bloodf/spoolancer/viewer/README.md

# Spoolancer assembly explorer

A standalone, offline-capable 3D view of the **OLED + five LEDs** and **five LEDs + web controls** enclosures. The v0.8.1 models use actual CAD tessellations, with eight independently selectable printed pieces: base, one-piece cradle, load-cell spacer, NFC tower, reader cassette, rear cover, glue-on base top cover and small NFC cable cap.

## Open locally

From this folder, run:

```sh
python3 -m http.server 8874 --bind 127.0.0.1
```

Open the [local viewer](http://127.0.0.1:8874/). A local HTTP server is necessary because browsers restrict module and asset loading through `file://`. No internet connection is needed after downloading the folder. Use a WebGL2-capable browser.

The viewer is also suitable for static hosting such as GitHub Pages. Every asset URL is relative. This folder is a separate desktop/browser deliverable; **do not copy it into the ESP32's web filesystem**.

## Explore

- Drag to orbit, scroll or pinch to zoom, right-drag or two-finger drag to pan. Focus the canvas and use arrow keys to pan.
- Move **Open the assembly** between assembled and exploded positions.
- Select a numbered component or a list entry. Use **Focus**, **Isolate part** or **Hide part** to inspect it.
- **See inside housing** makes the base, cradle, reader tower, cassette, rear cover, base top cover and cable cap transparent. Hardware references, the spool, cable/clearance references and part numbers have separate toggles.
- **Cable / clearances** shows the nominal reader wire loop and its tail into the base. These are representative spaces, not simulated wires at every reader height.
- **Reset** restores the complete assembled model. **Fit view** frames the visible parts. Standard front, side and top views are available.
- Both light and dark themes work locally; the preference is saved when browser storage is available.

No converter, converter mount or reserved converter volume is modeled. Fit and insulate a 12 V-to-5 V converter against a suitable fixed wall only after checking the actual board, cable route and clearances. Hardware envelopes remain provisional. Any cable paths shown are dimensional references, not qualified cable assemblies. Electrical terminations, threads, screw drives, adhesive and the user-drilled jack are not represented. Exploded offsets illustrate component locations, not a collision-free assembly sequence. Original CAD coordinates are retained at 0% explosion. Flat face shading preserves mechanical edges; the viewer does not smooth or modify the shape.

The spool and glued reader tower sit on one floating cradle with integral ramps and fixed sides. Only reader height adjusts. The base, glued top cover, cable cap and front controls stay fixed. To service the base, remove the spool, disconnect power and the NFC lead, then remove the two moving-end load-cell screws and lift the cradle while supporting its spacer. The top cover remains fixed; electronics access requires releasing its glue joint. The viewer's exploded offsets do not illustrate this service motion. Physical fit, strength, bond retention and weighing accuracy remain untested.

## Rebuild and verify from the repository

```sh
python3 tools/build_viewer.py
python3 tools/build_viewer.py --check
node viewer/model.test.mjs
```

No FreeCAD installation is needed for these commands. Regenerate CAD scenes first when geometry changes. The builder consumes `cad/variants/{headless-led,oled-led}/previews/scene.json` and the shared `cad/assembly-parts.json` numbering, descriptions and explode offsets. It fails on unmapped meshes, duplicated assignments, missing components, malformed triangles, non-finite coordinates or any printed instance without its own selectable part. `--check` checks exact generated bytes without changing files.

The output pairs in `assets/` contain compact Float32 positions and Uint32 triangle indices, plus source and binary SHA-256 hashes. Float32 conversion introduces only normal floating-point rounding at this scale. CAD STEP and FreeCAD files remain the manufacturing source of truth. All binary arrays use little-endian storage.

## Dependencies and license

- Three.js **0.180.0 / r180**, including OrbitControls: MIT. The pinned upstream files and full notice are in `vendor/`. Source: [three.js r180](https://github.com/mrdoob/three.js/tree/r180).
- Spoolancer viewer, metadata and generated geometry: MIT, same as the project. See `LICENSE` in this folder.
- The icon is the project's existing Spoolancer brand asset.

No CDN is contacted at runtime. The Three.js files were obtained from the version-pinned package paths under `https://unpkg.com/three@0.180.0/`; `vendor/SHA256SUMS.txt` records their exact bytes. The generated viewer assets include their source hashes so static hosting can be audited against the committed CAD scenes.
