bloodf/spoolancer/archive/v0.1-flat/SUPERSEDED.md

Superseded by the upright v0.2 design. The user rejected the flat spool orientation. This folder preserves the prior files for reference only. Do not use these files for the current build.
