bloodf/spoolancer/archive/v0.2-upright/SUPERSEDED.md

Superseded by the compact v0.3 design with side-mounted NFC. This folder preserves v0.2 for reference only.
