bloodf/spoolancer/cad/previews/boot-access.png

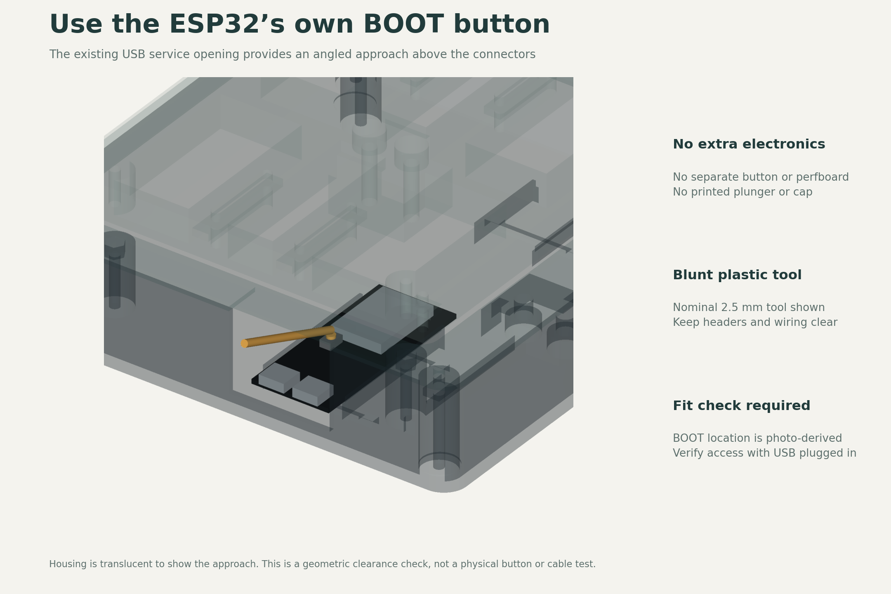
cad/previews/boot-access.png
