bloodf/spoolancer/cad/previews/cradle.png

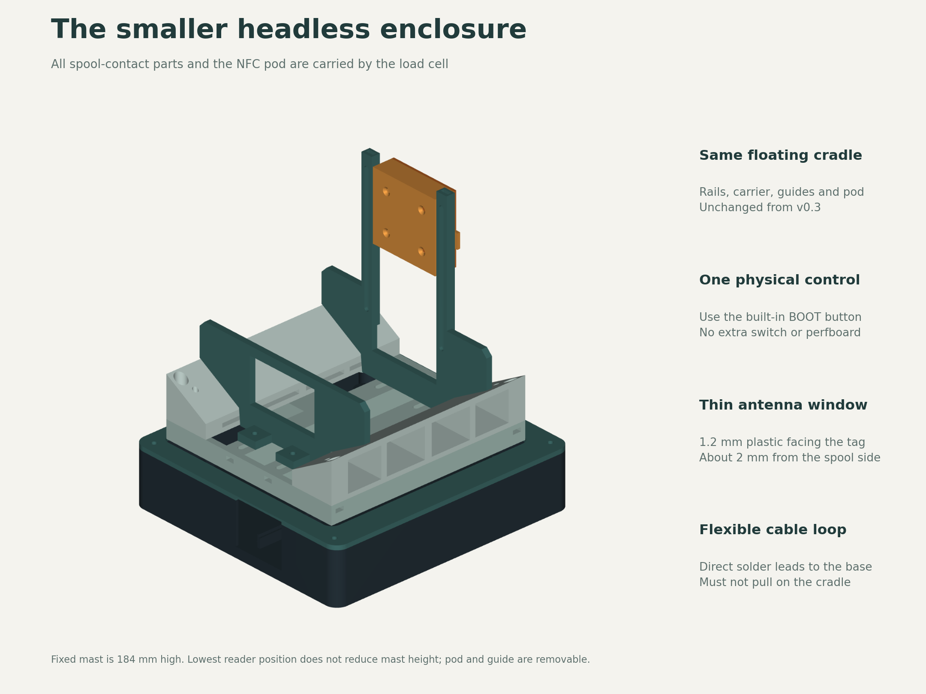
cad/previews/cradle.png
