bloodf/spoolancer/cad/previews/exploded.png

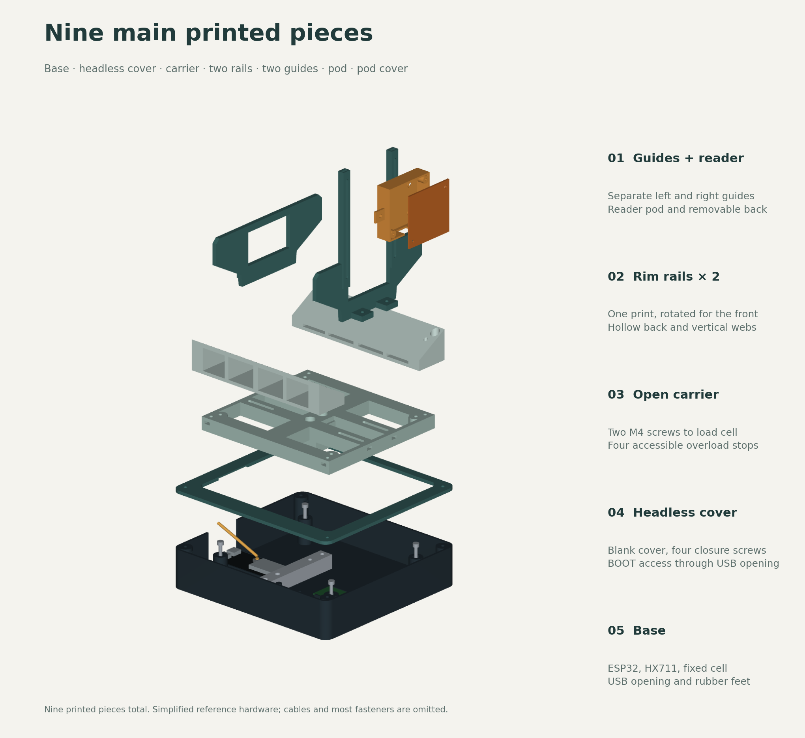
cad/previews/exploded.png
