bloodf/spoolancer/cad/previews/interior.png

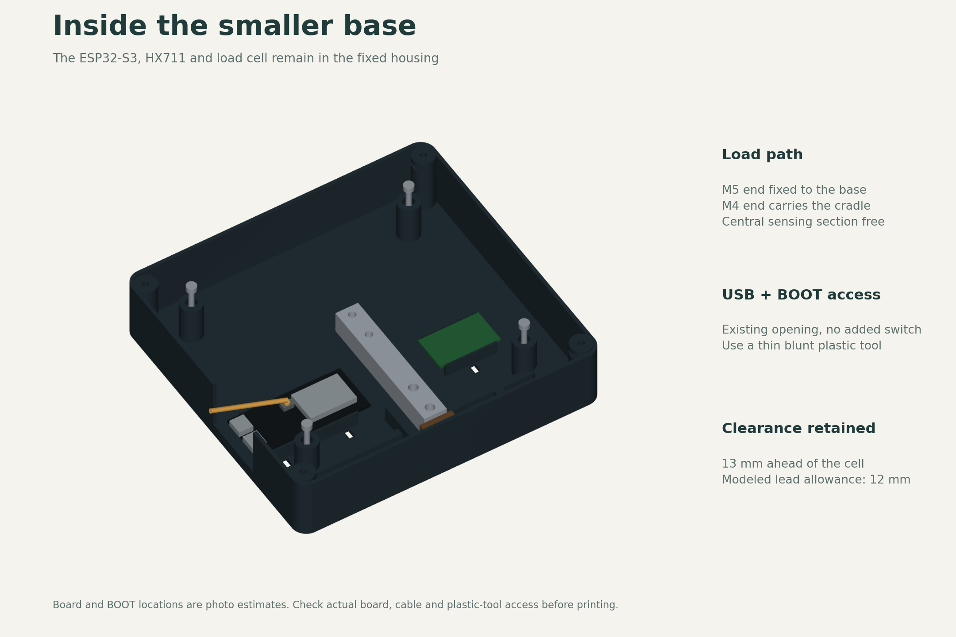
cad/previews/interior.png
