bloodf/spoolancer/cad/previews/load-path.png

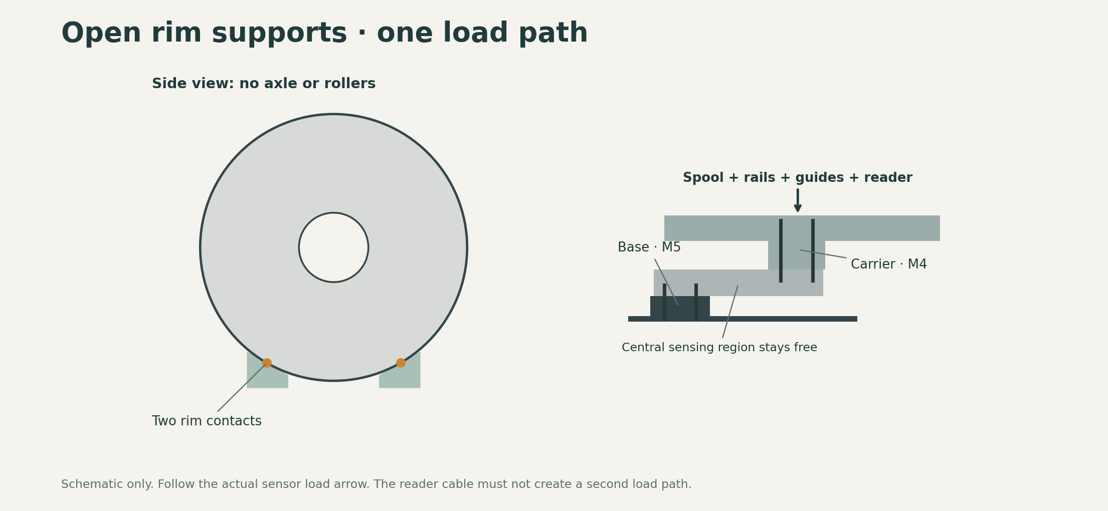
cad/previews/load-path.png
