bloodf/spoolancer/cad/previews/nfc-detail.png

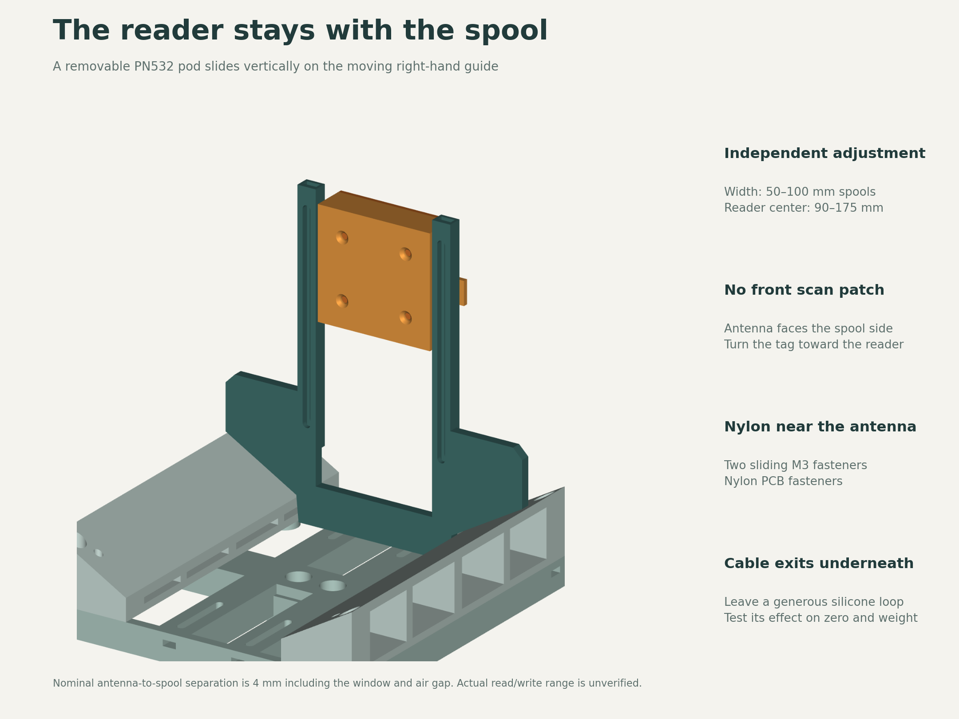
cad/previews/nfc-detail.png
