bloodf/spoolancer/cad/variants/headless-led/previews/cable-routing.png

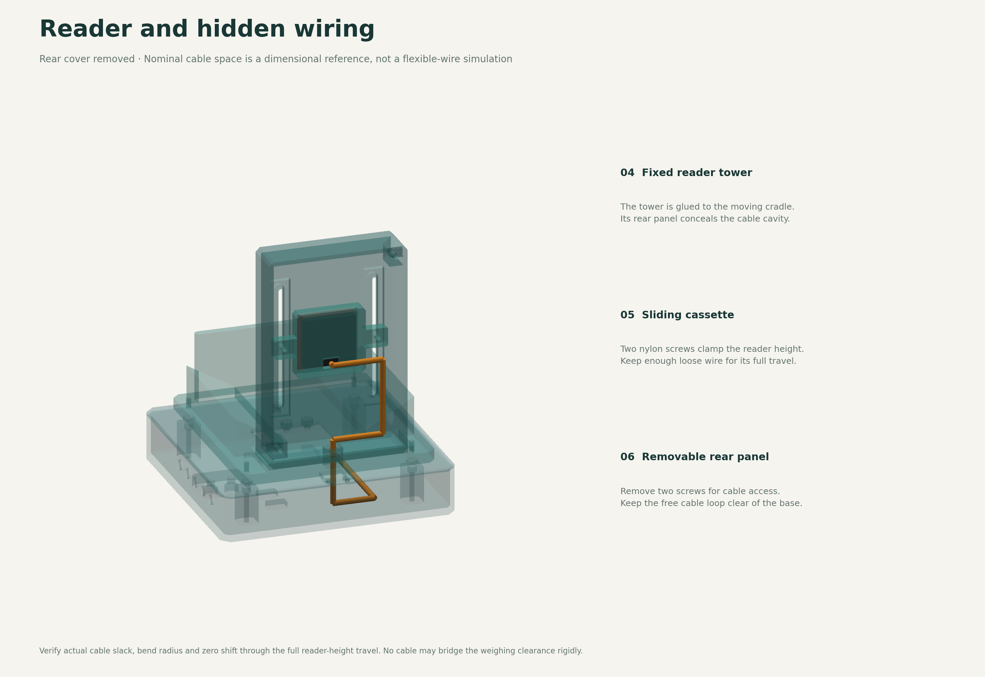
cad/variants/headless-led/previews/cable-routing.png
