bloodf/spoolancer/cad/variants/headless-led/previews/cradle.png

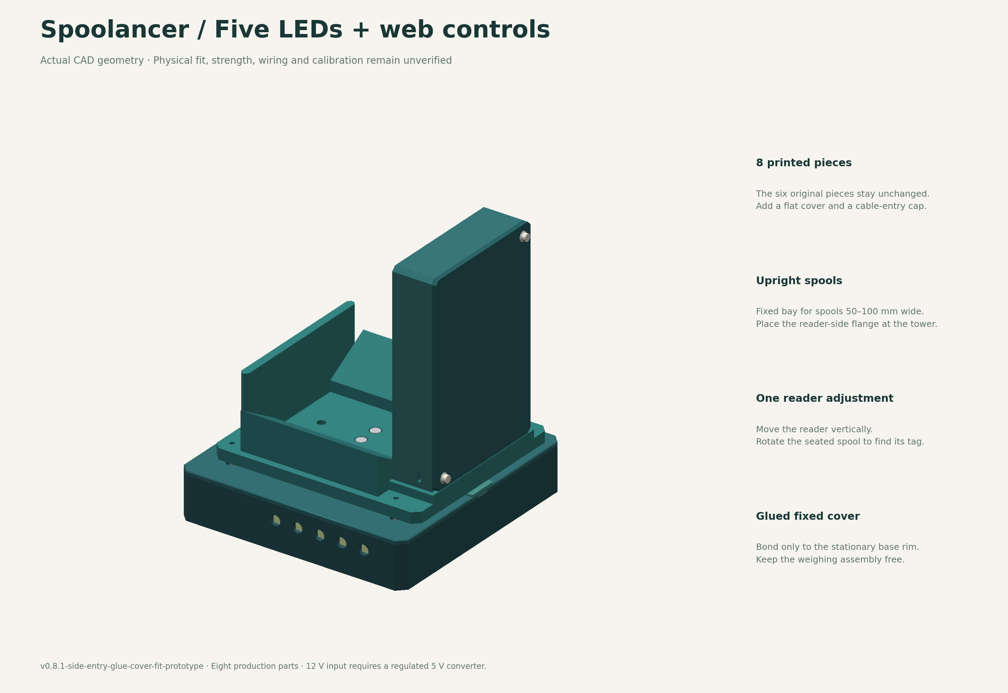
cad/variants/headless-led/previews/cradle.png
