bloodf/spoolancer/cad/variants/headless-led/previews/edge-detail.png

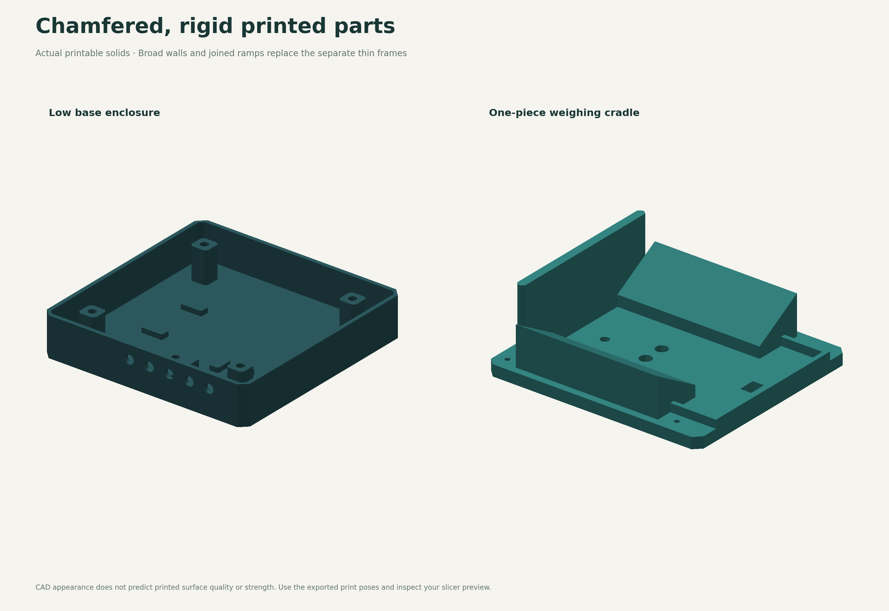
cad/variants/headless-led/previews/edge-detail.png
