bloodf/spoolancer/cad/variants/headless-led/previews/indicator-detail.png

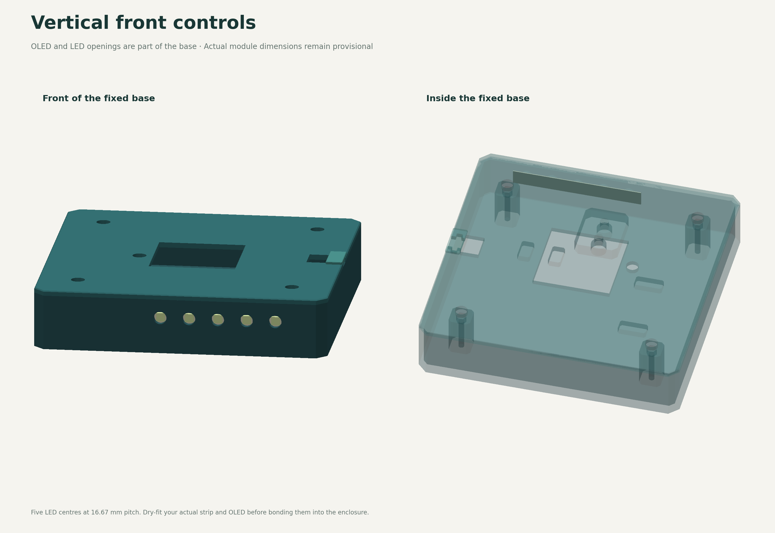
cad/variants/headless-led/previews/indicator-detail.png
