bloodf/spoolancer/cad/variants/headless-led/previews/service-interior.png

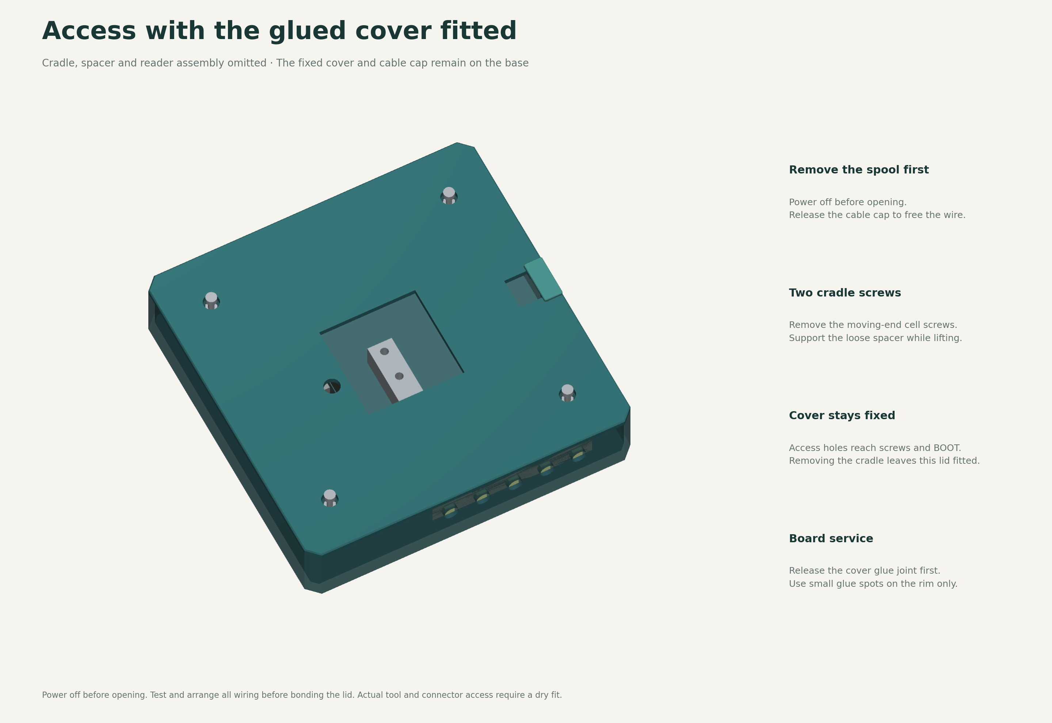
cad/variants/headless-led/previews/service-interior.png
