bloodf/spoolancer/cad/variants/oled-led/previews/cradle.png

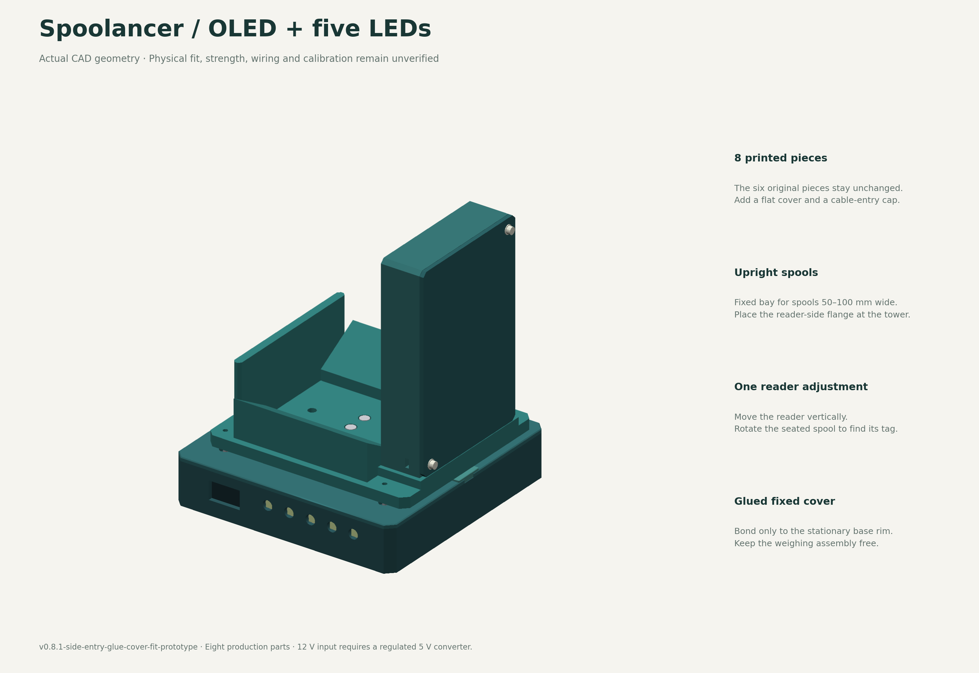
cad/variants/oled-led/previews/cradle.png
