bloodf/spoolancer/cad/variants/touch-8048/previews/touch-back.png

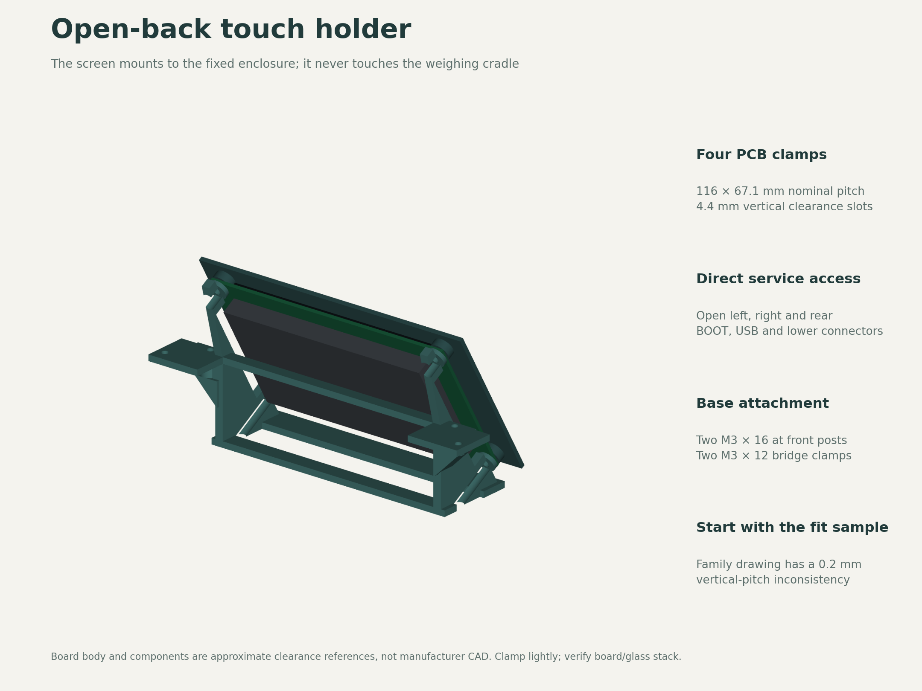
cad/variants/touch-8048/previews/touch-back.png
