bloodf/spoolancer/docs/nfc-cable-gate-viewer.png

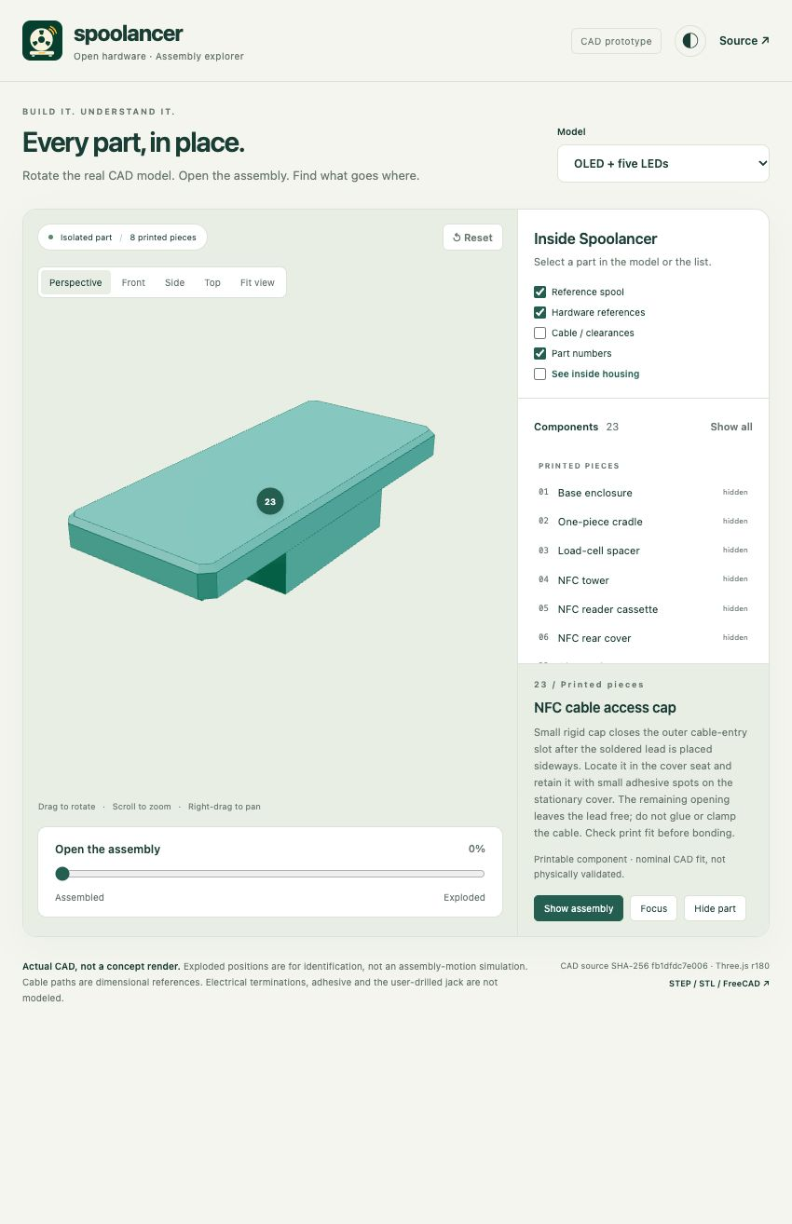
docs/nfc-cable-gate-viewer.png
