bloodf/spoolancer/docs/reference/esp32-s3-n16r8-v6.png

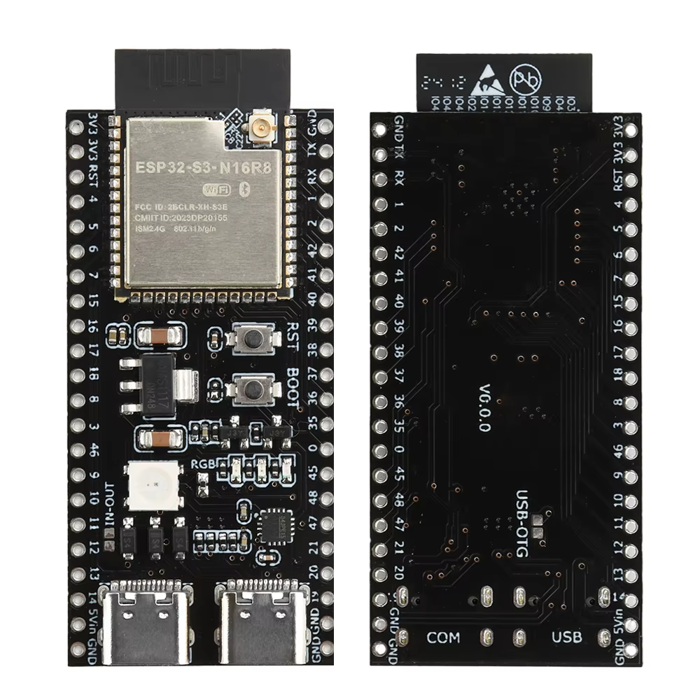
docs/reference/esp32-s3-n16r8-v6.png
