bloodf/spoolancer/docs/reference/guition-outline.png

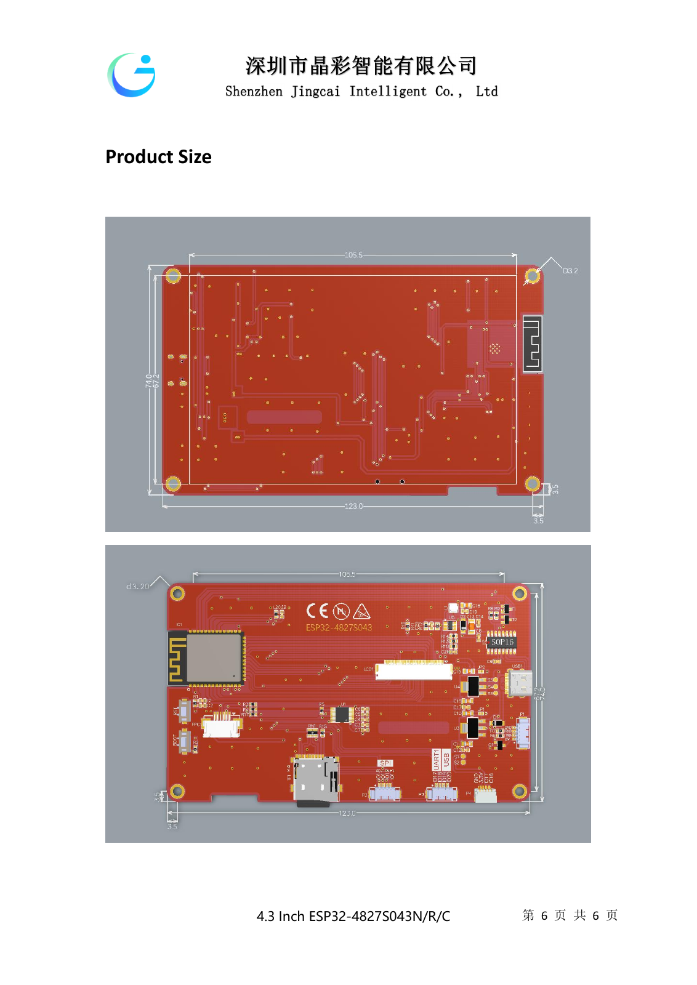
docs/reference/guition-outline.png
