bloodf/spoolancer/docs/reference/pn532-v3-listing.png

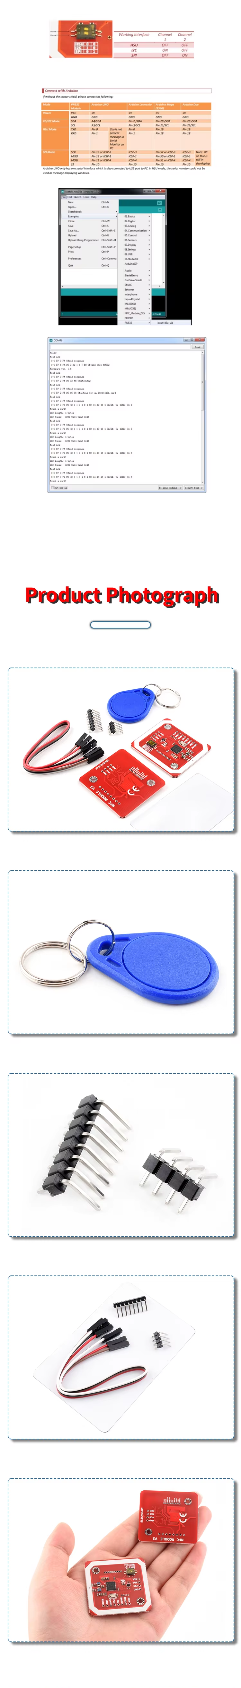
docs/reference/pn532-v3-listing.png
