bloodf/spoolancer/docs/reference/touch-listing-back.png

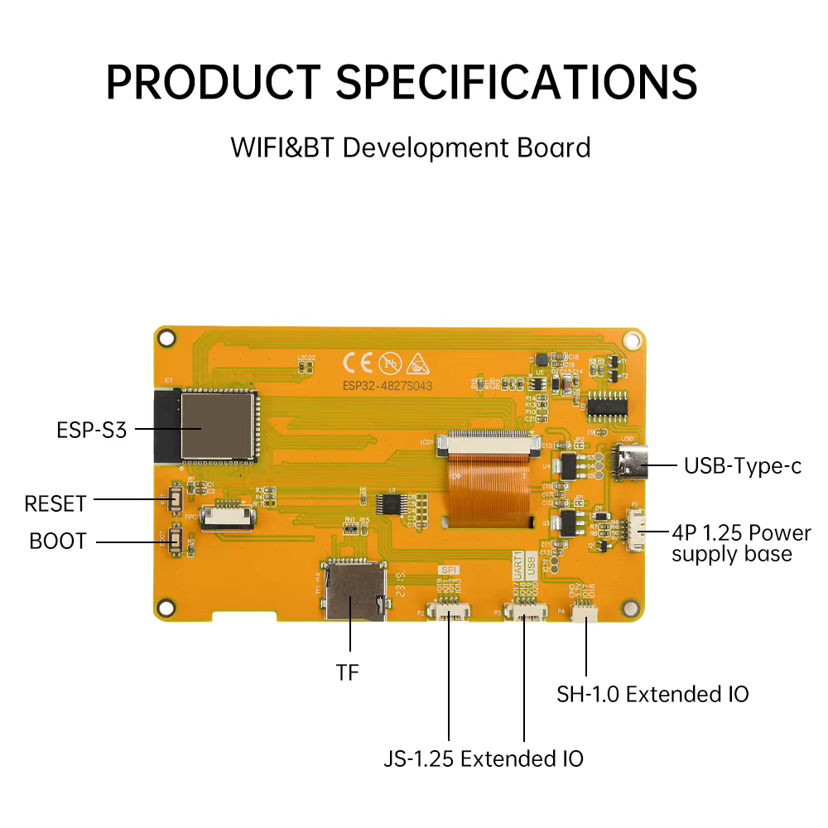
docs/reference/touch-listing-back.png
