bloodf/spoolancer/docs/reference/touch-listing-model.png

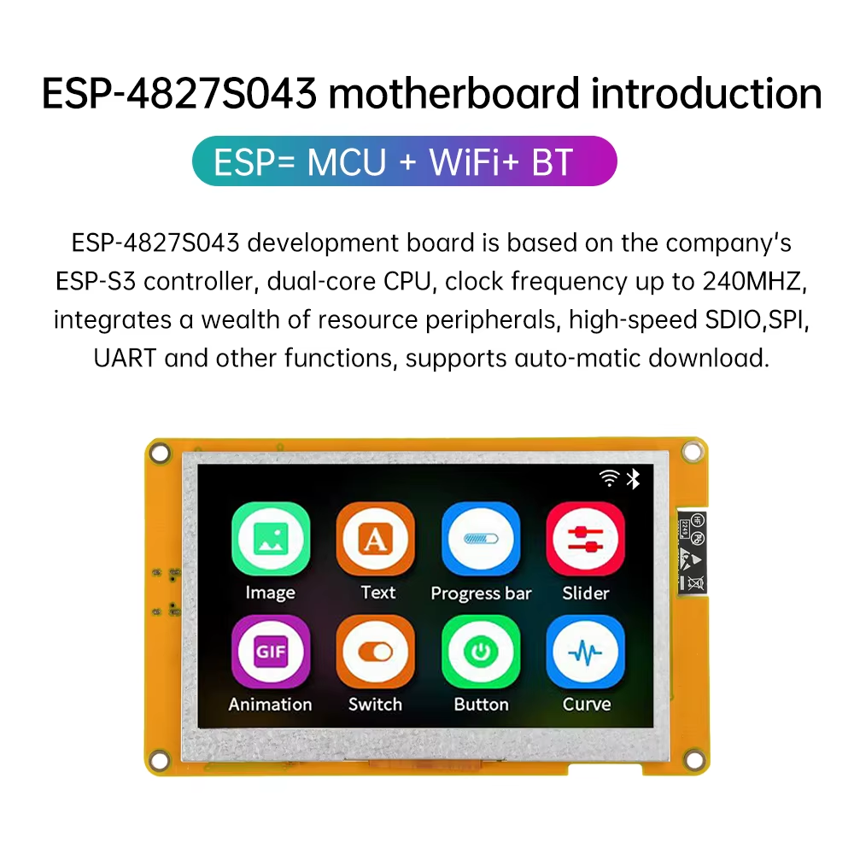
docs/reference/touch-listing-model.png
