bloodf/spoolancer/docs/reference/touch-listing-size.png

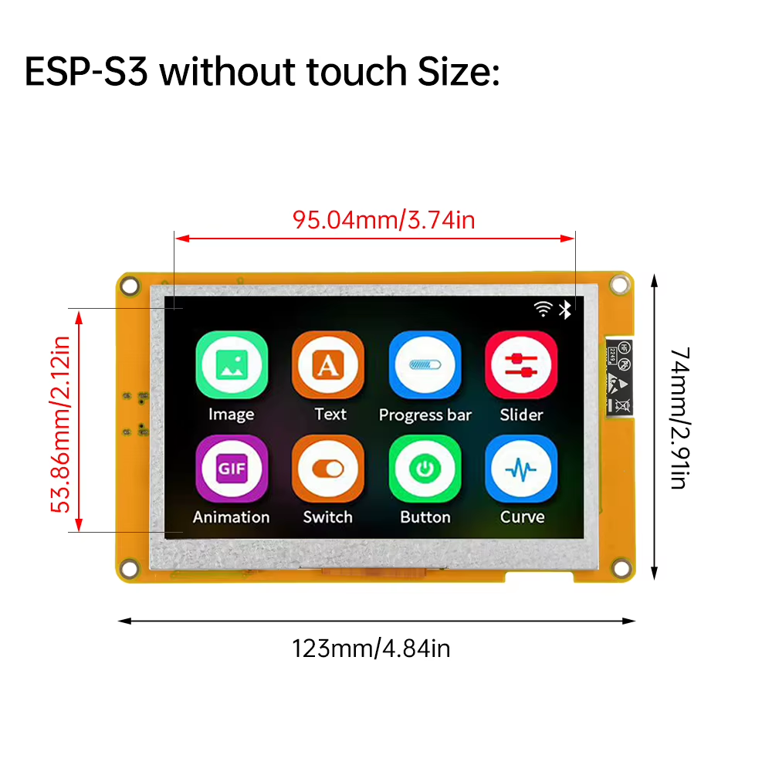
docs/reference/touch-listing-size.png
