bloodf/spoolancer/docs/top-cover-viewer.png

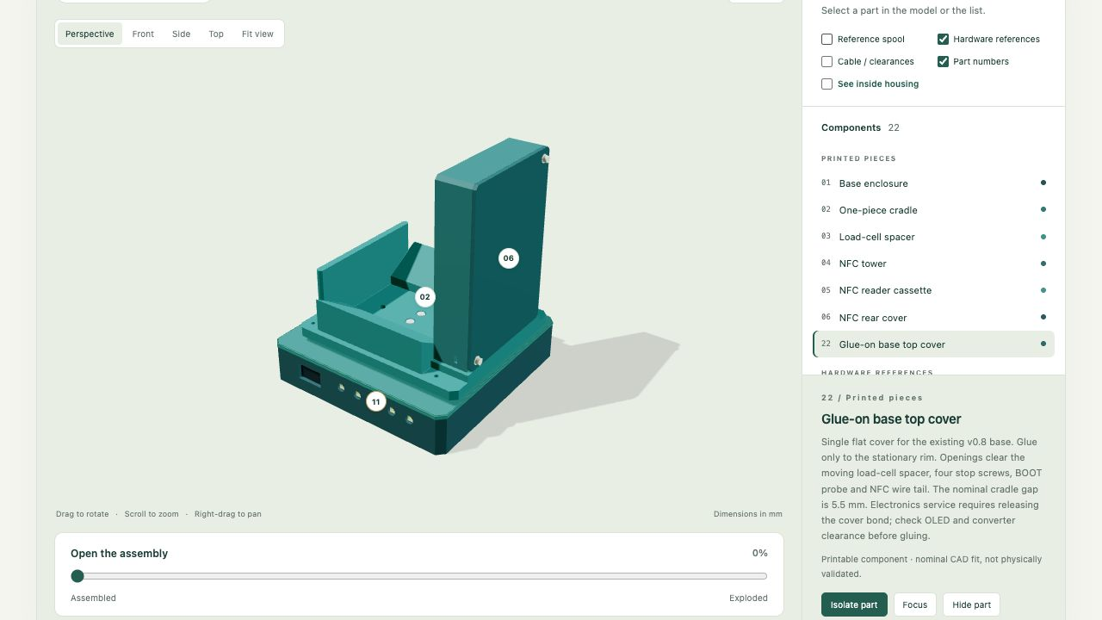
docs/top-cover-viewer.png
