bloodf/spoolancer/docs/web-hardware-device.png

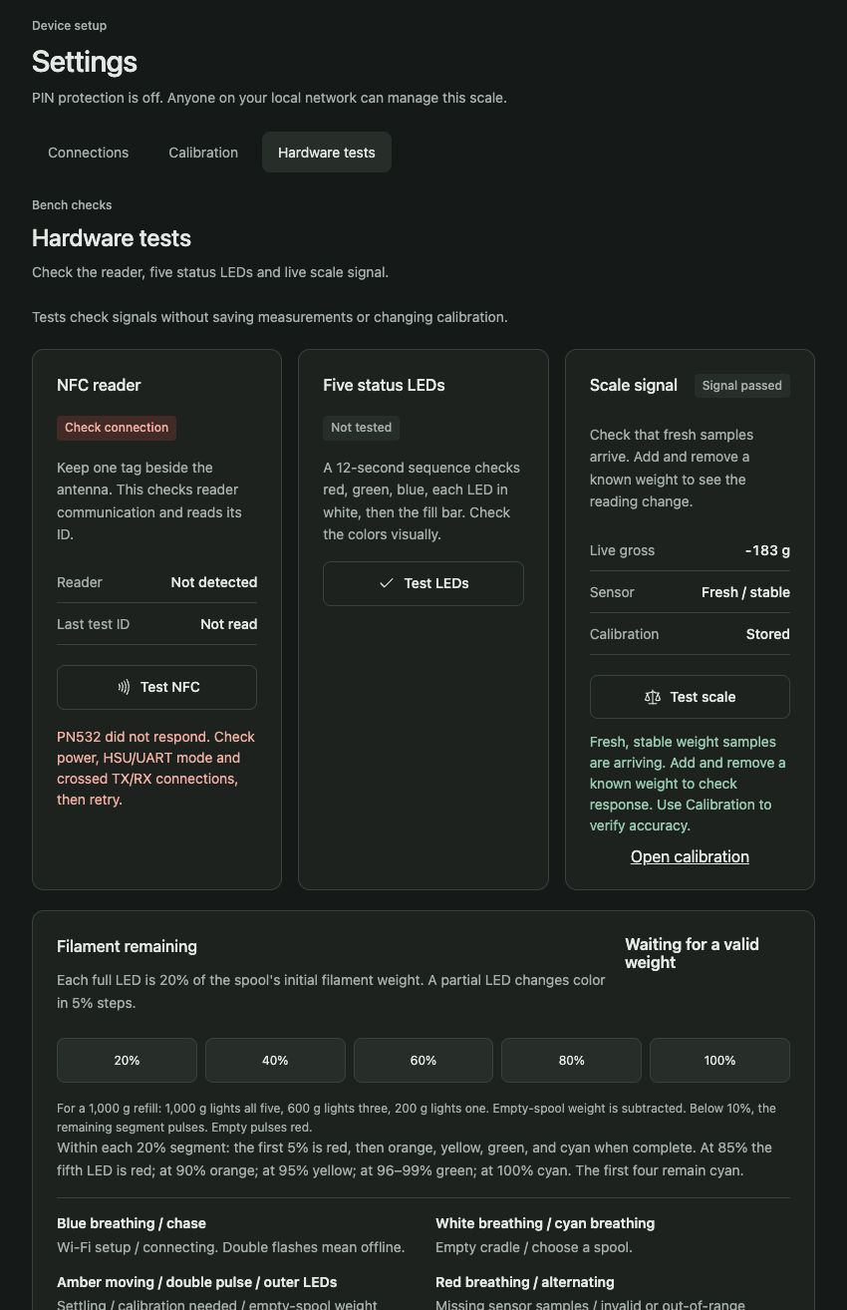
docs/web-hardware-device.png
