bloodf/spoolancer/docs/web-preview.png

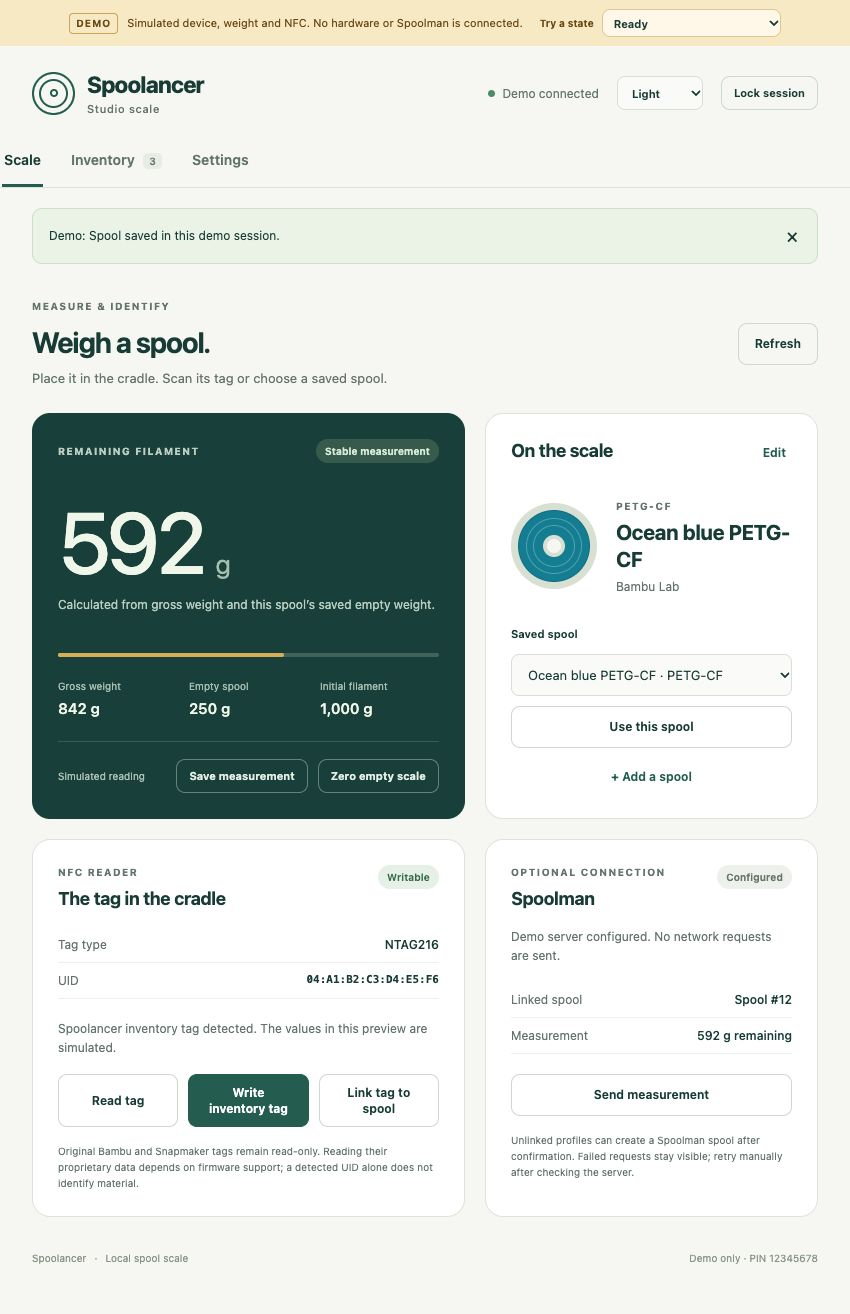
docs/web-preview.png
