bloodf/spoolancer/docs/web-rfid-link.png

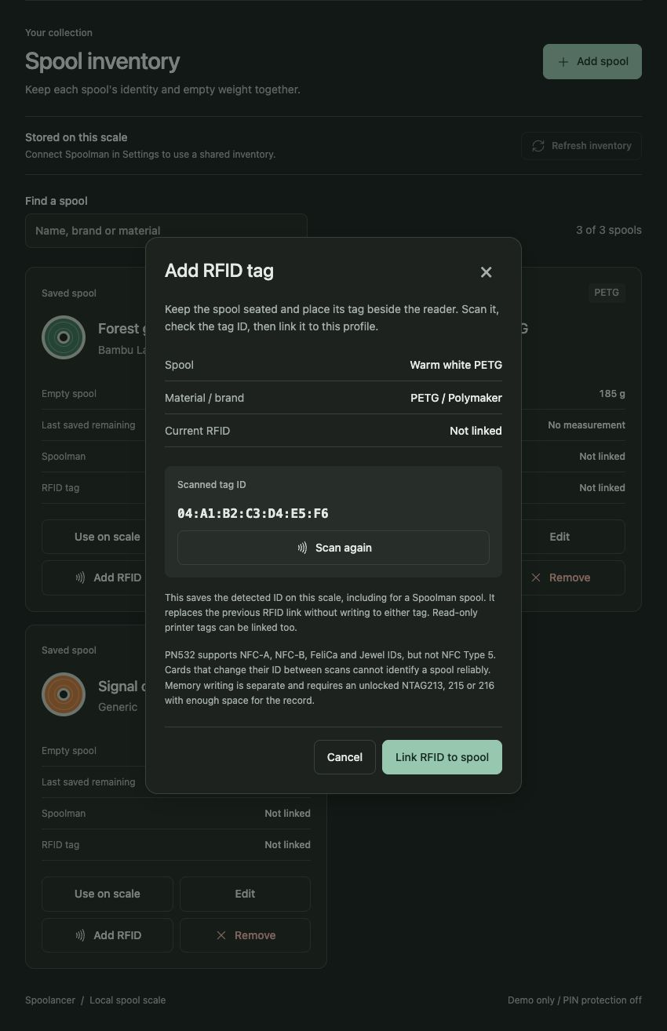
docs/web-rfid-link.png
