bloodf/spoolancer/docs/web-scale-updated.png

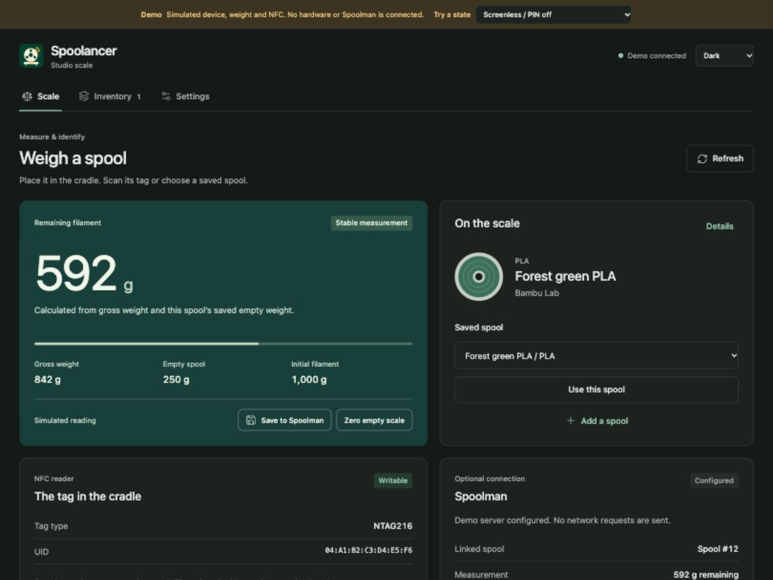
docs/web-scale-updated.png
