bloodf/spoolancer/docs/web-settings-updated.png

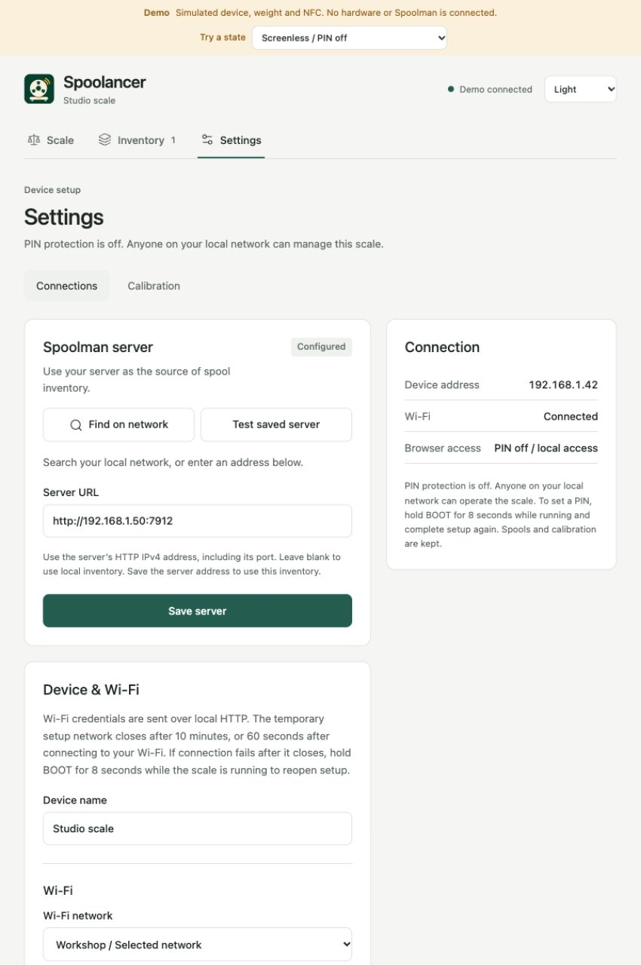
docs/web-settings-updated.png
