bloodf/spoolancer/cad/variants/headless-led/previews/component-locations.png

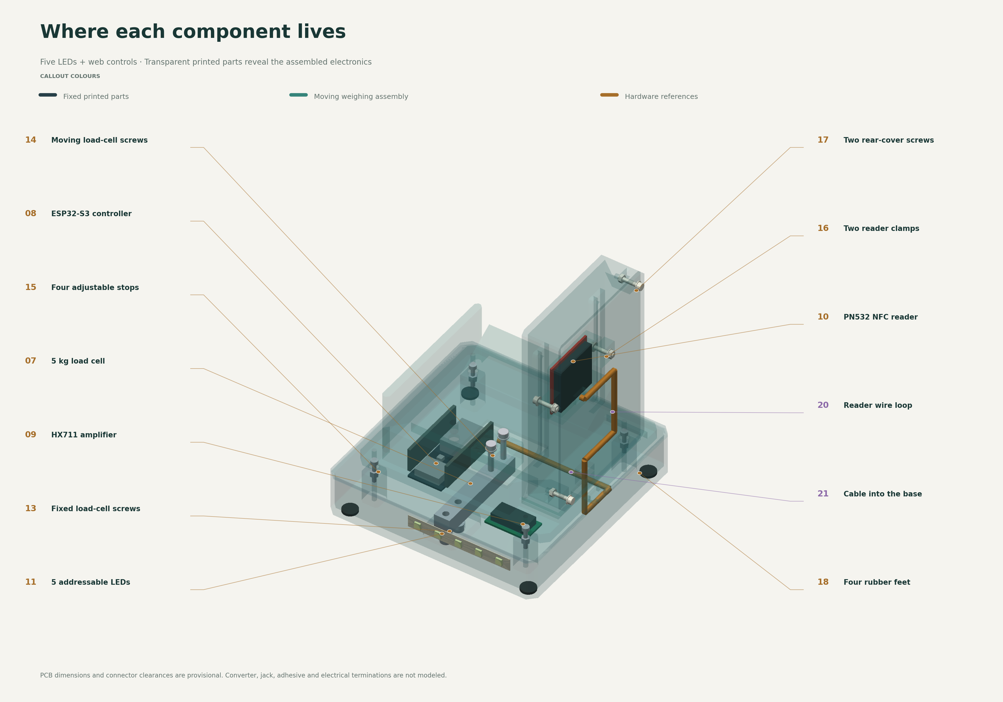
cad/variants/headless-led/previews/component-locations.png
