bloodf/spoolancer/docs/web-inventory-rfid.png

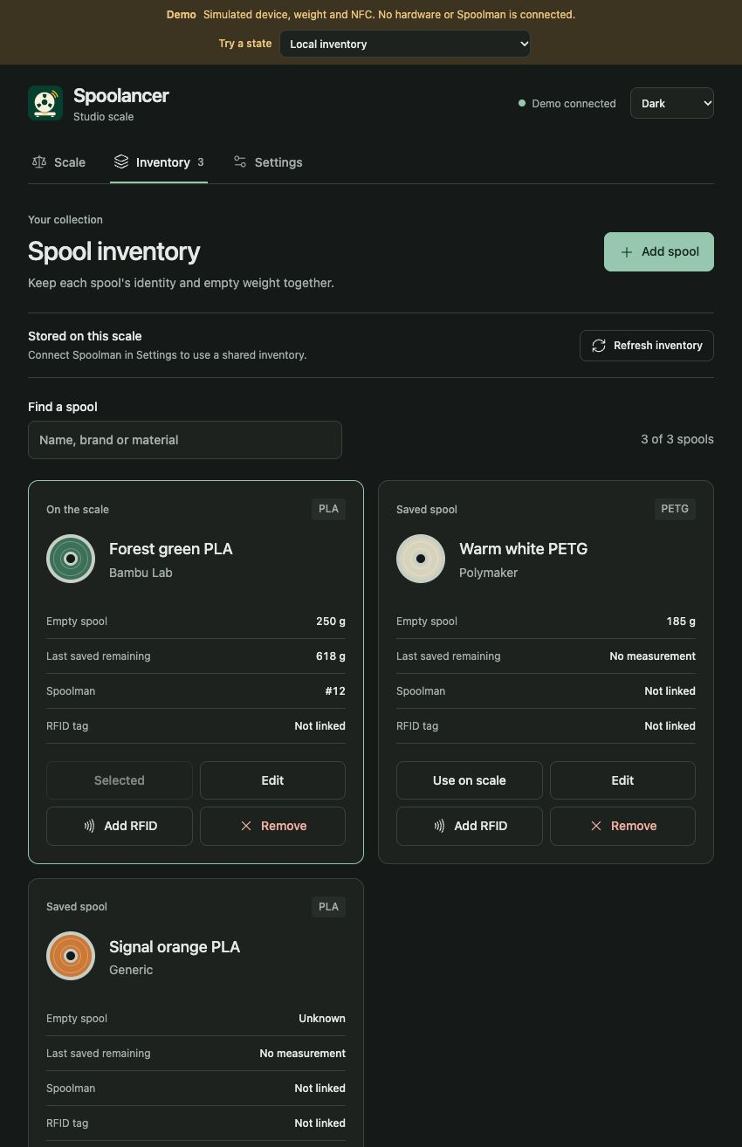
docs/web-inventory-rfid.png
