bloodf/spoolancer/cad/variants/headless-led/exports/spoolancer-v0.8.1-headless-led-assembly.step

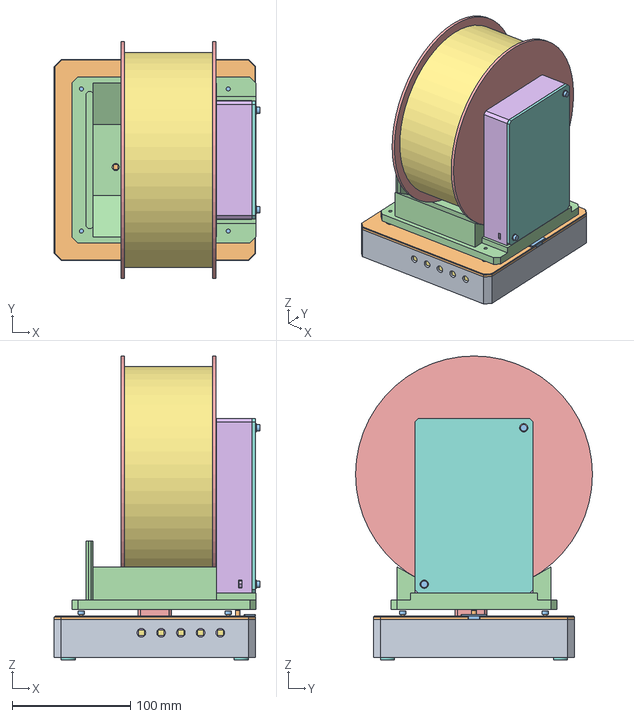
[picture p39: CAD file, 2026-11-02]
cad/variants/headless-led/exports/spoolancer-v0.8.1-headless-led-assembly.step
173.7 x 200.0 x 256.6 mm
