bloodf/spoolancer/cad/variants/touch-8048/exports/spoolancer-v0.4-touch-8048-assembly.step

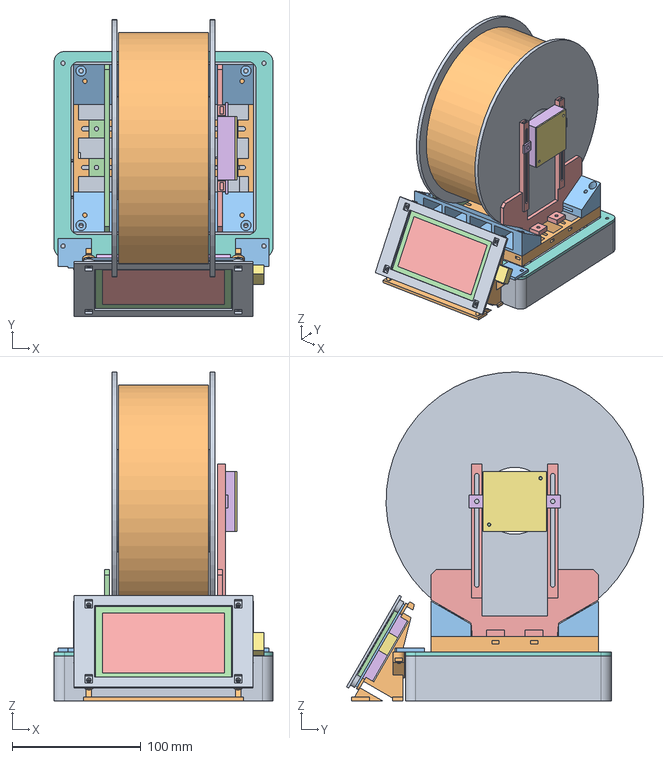
[picture p40: CAD file, 2026-10-27]
cad/variants/touch-8048/exports/spoolancer-v0.4-touch-8048-assembly.step
170.0 x 230.7 x 255.5 mm
