bloodf/spoolancer/cad/exports/spoolancer-v0.4.1-headless-assembly.step

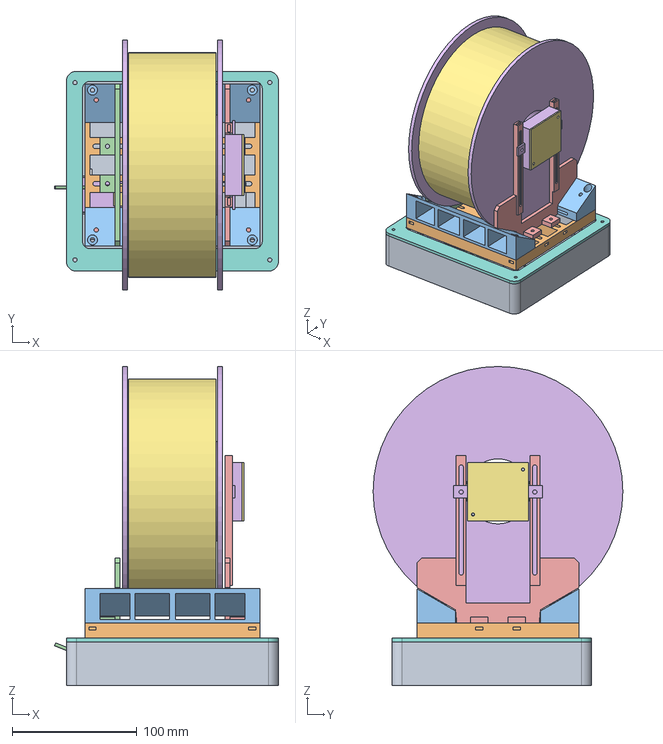
[picture p41: CAD file, 2026-10-27]
cad/exports/spoolancer-v0.4.1-headless-assembly.step
179.5 x 200.0 x 255.5 mm
