bloodf/spoolancer/cad/exports/side_guide.step

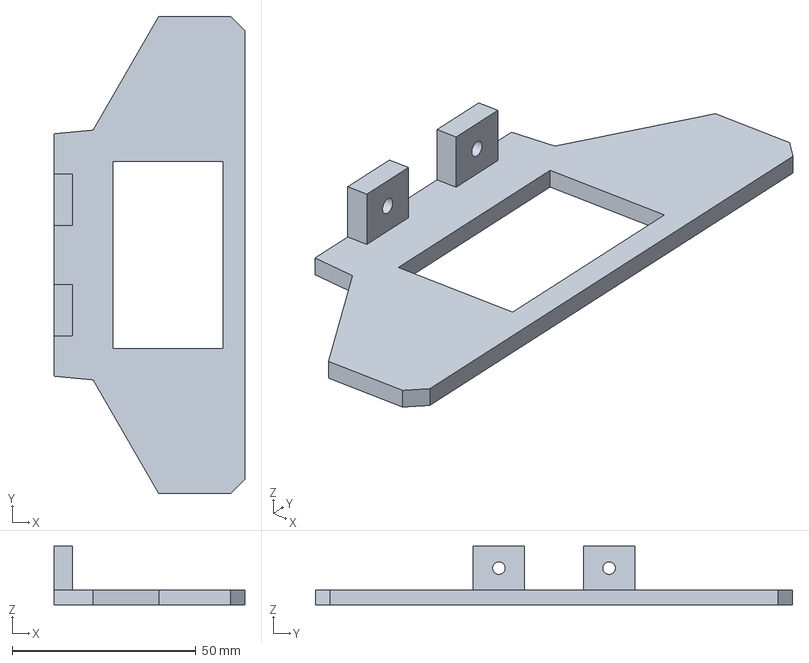
[picture p42: CAD file, 2026-10-27]
cad/exports/side_guide.step
52.0 x 130.0 x 16.0 mm
