bloodf/spoolancer/cad/variants/headless/exports/nfc_guide.step

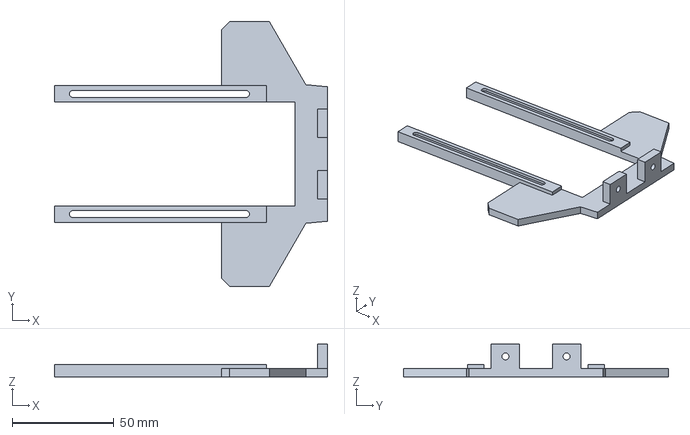
[picture p43: CAD file, 2026-10-27]
cad/variants/headless/exports/nfc_guide.step
134.0 x 130.0 x 16.0 mm
