bloodf/spoolancer/cad/variants/oled-led/exports/cell_spacer.step

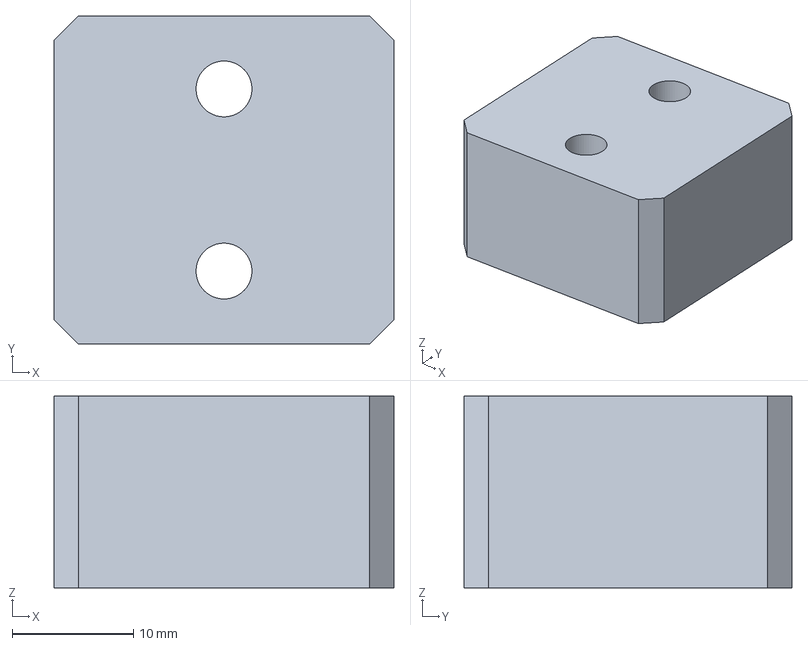
[picture p44: CAD file, 2026-11-02]
cad/variants/oled-led/exports/cell_spacer.step
28.0 x 27.0 x 15.8 mm
