bloodf/spoolancer/cad/variants/touch-8048/exports/touch_stand.step

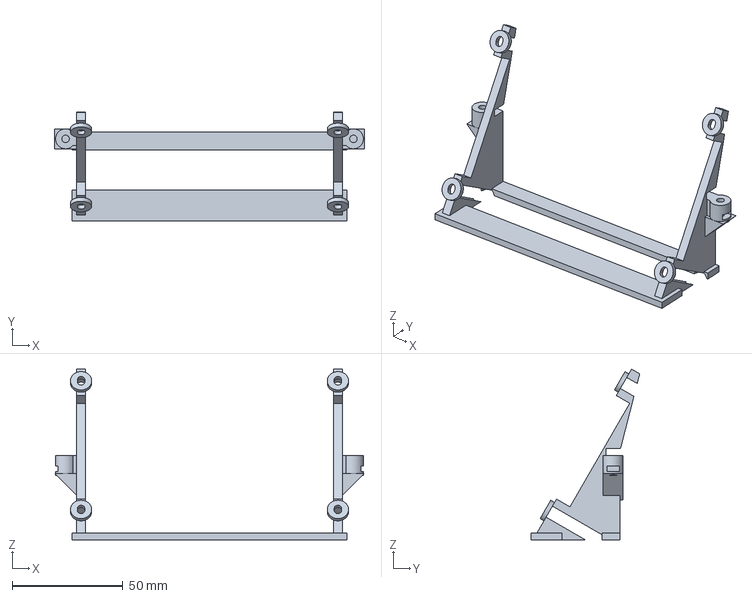
[picture p45: CAD file, 2026-10-27]
cad/variants/touch-8048/exports/touch_stand.step
140.0 x 49.0 x 77.1 mm
