bloodf/spoolancer/cad/exports/top_cover.step

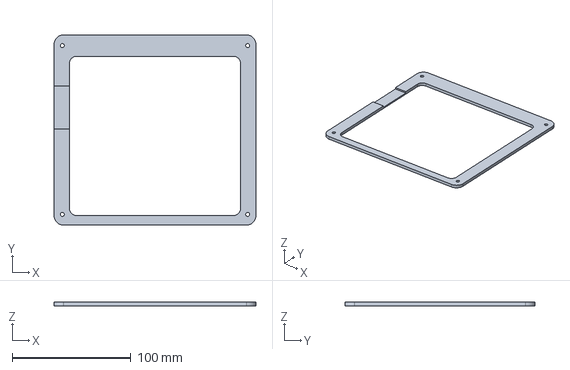
[picture p46: CAD file, 2026-10-27]
cad/exports/top_cover.step
170.0 x 160.0 x 3.00 mm
