bloodf/spoolancer/cad/variants/headless-led/exports/base_top_cover.step

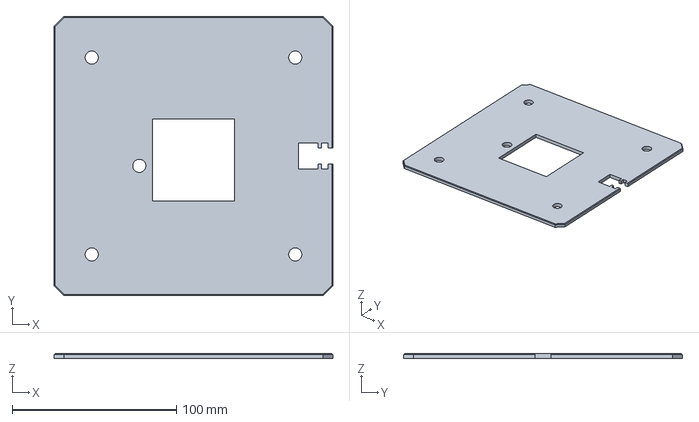
[picture p47: CAD file, 2026-11-02]
cad/variants/headless-led/exports/base_top_cover.step
170.0 x 170.0 x 3.00 mm
