bloodf/spoolancer/cad/variants/headless/exports/carrier.step

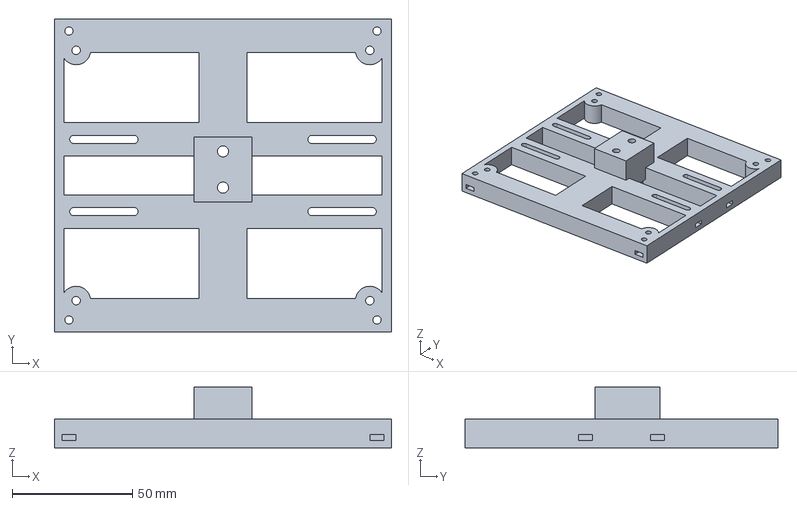
[picture p48: CAD file, 2026-10-27]
cad/variants/headless/exports/carrier.step
140.0 x 130.0 x 25.3 mm
