bloodf/spoolancer/cad/variants/oled-led/exports/base.step

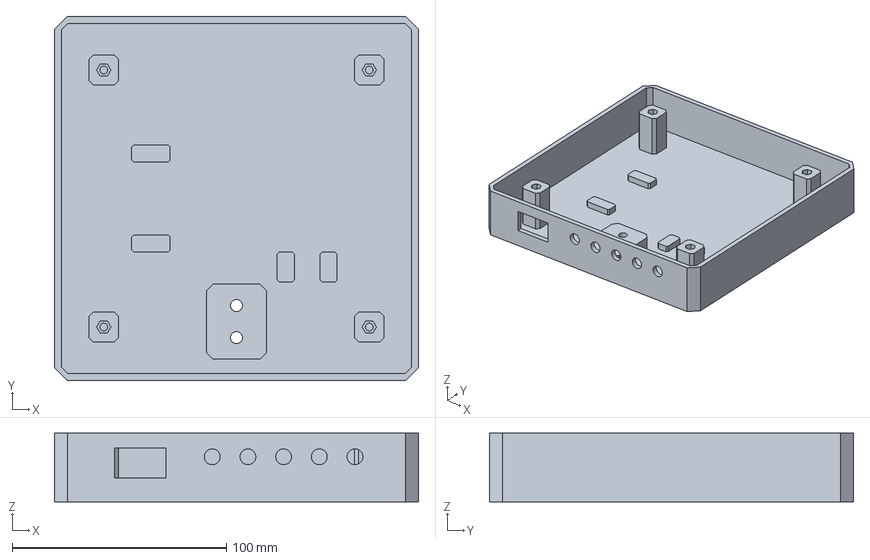
[picture p49: CAD file, 2026-11-02]
cad/variants/oled-led/exports/base.step
170.0 x 170.0 x 32.0 mm
