bloodf/spoolancer/cad/variants/headless/exports/fit_nfc.step

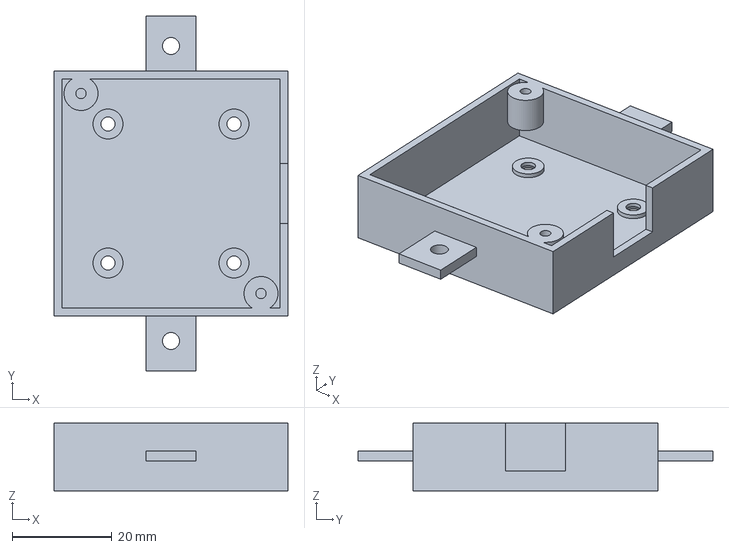
[picture p50: CAD file, 2026-10-27]
cad/variants/headless/exports/fit_nfc.step
46.8 x 71.0 x 13.6 mm
