bloodf/spoolancer/cad/variants/oled-led/exports/nfc_tower.step

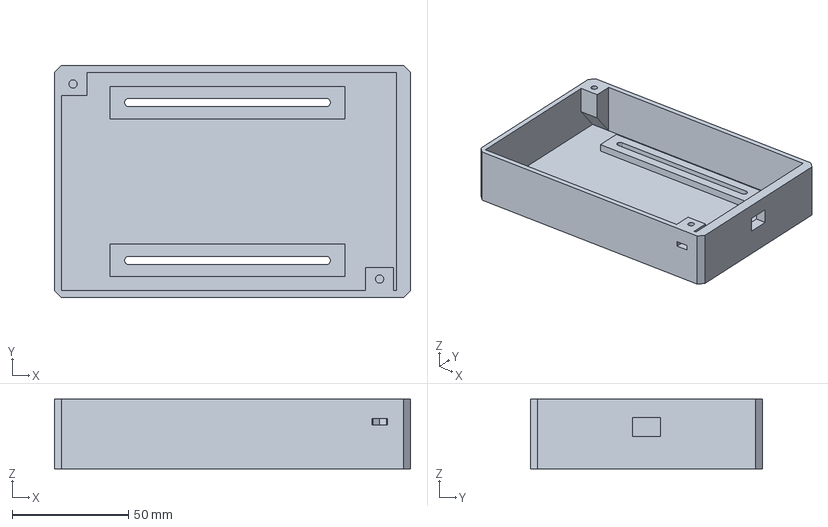
[picture p51: CAD file, 2026-11-02]
cad/variants/oled-led/exports/nfc_tower.step
153.3 x 100.0 x 30.0 mm
