bloodf/spoolancer/cad/exports/nfc_pod_cover.step

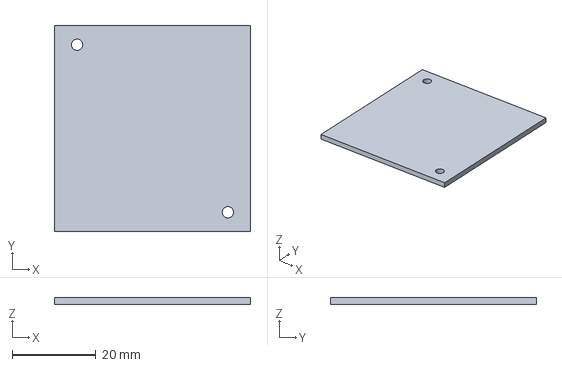
[picture p52: CAD file, 2026-10-27]
cad/exports/nfc_pod_cover.step
46.8 x 49.1 x 1.60 mm
