bloodf/spoolancer/cad/variants/oled-led/exports/nfc_cable_gate.step

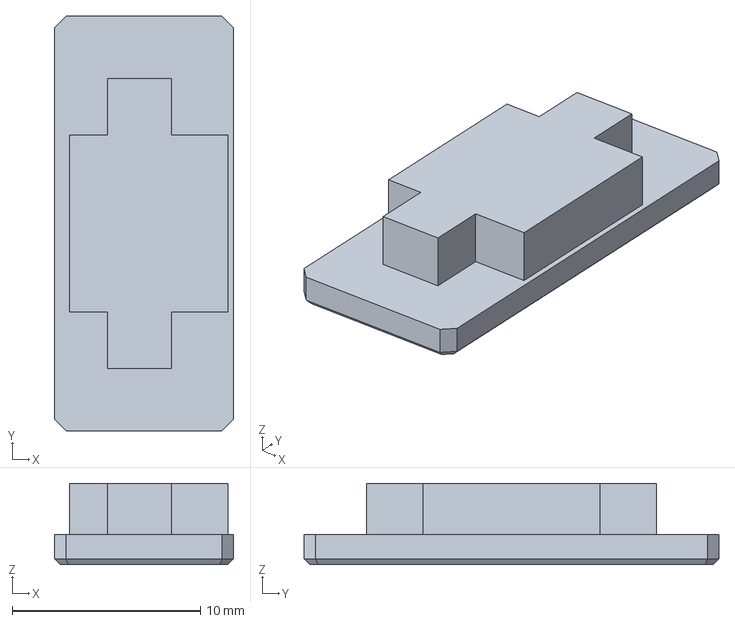
[picture p53: CAD file, 2026-11-02]
cad/variants/oled-led/exports/nfc_cable_gate.step
9.50 x 22.0 x 4.30 mm
