bloodf/spoolancer/cad/variants/touch-8048/exports/fit_cell.step

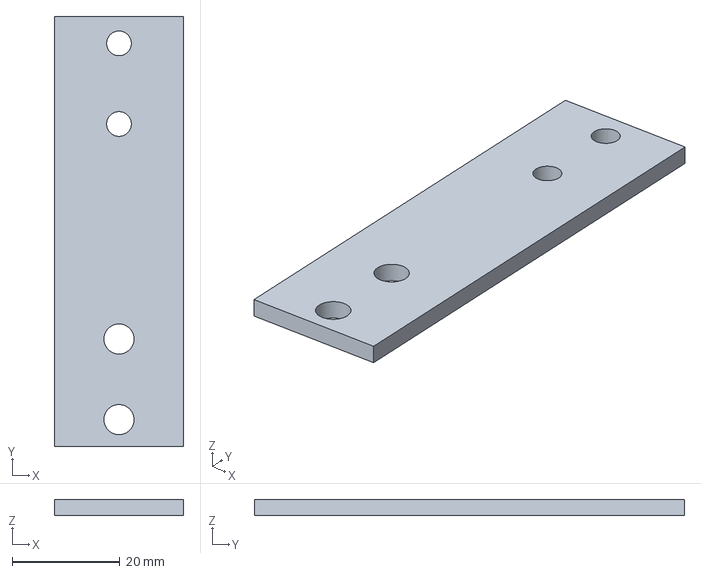
[picture p54: CAD file, 2026-10-27]
cad/variants/touch-8048/exports/fit_cell.step
24.0 x 80.0 x 3.00 mm
