bloodf/spoolancer/cad/variants/headless/exports/base.step

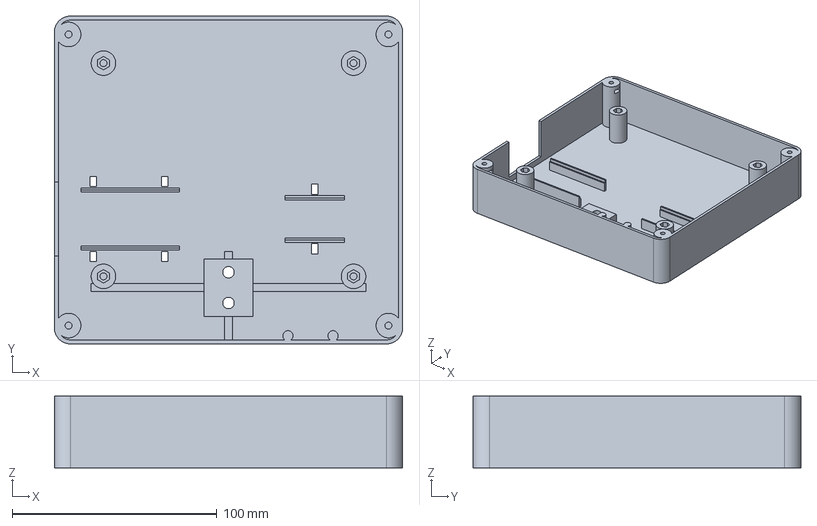
[picture p55: CAD file, 2026-10-27]
cad/variants/headless/exports/base.step
170.0 x 160.0 x 35.0 mm
