bloodf/spoolancer/cad/variants/oled-led/exports/cradle.step

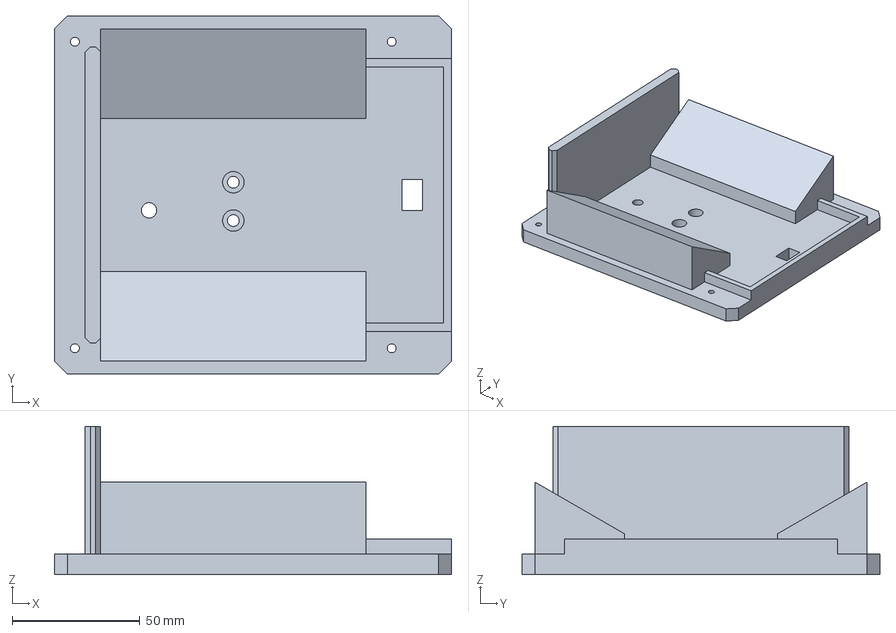
[picture p56: CAD file, 2026-11-02]
cad/variants/oled-led/exports/cradle.step
155.4 x 140.0 x 58.0 mm
