bloodf/spoolancer/cad/variants/headless-led/exports/nfc_cassette.step

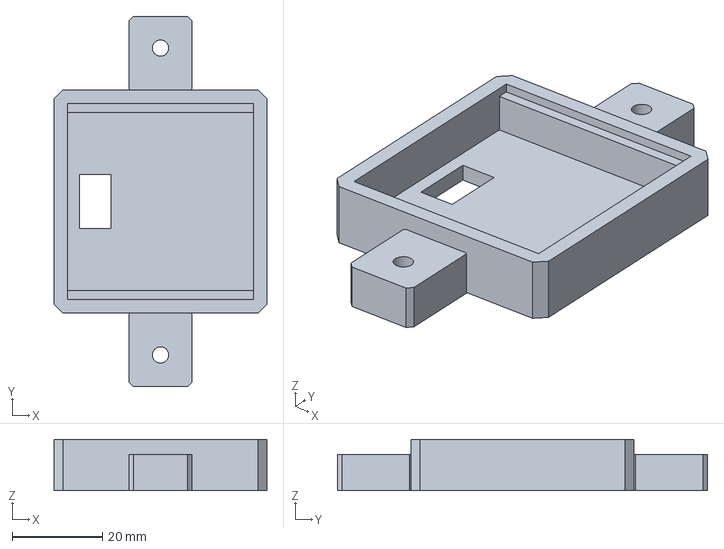
[picture p57: CAD file, 2026-11-02]
cad/variants/headless-led/exports/nfc_cassette.step
47.2 x 82.0 x 11.4 mm
