bloodf/spoolancer/cad/variants/oled-led/exports/nfc_cover.step

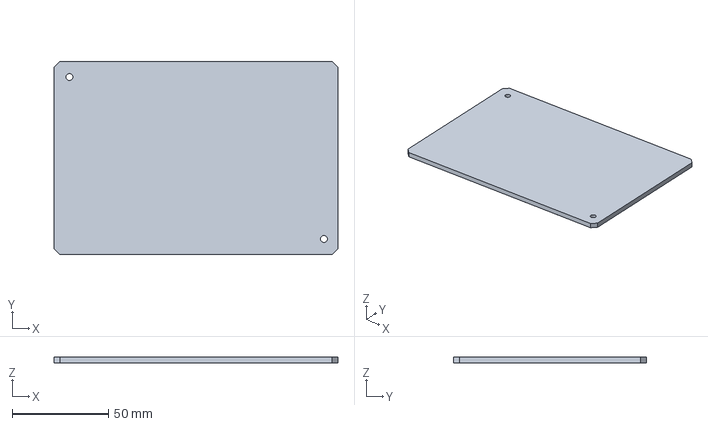
[picture p58: CAD file, 2026-11-02]
cad/variants/oled-led/exports/nfc_cover.step
147.3 x 100.0 x 3.00 mm
