bloodf/spoolancer/cad/variants/touch-8048/exports/rim_rail.step

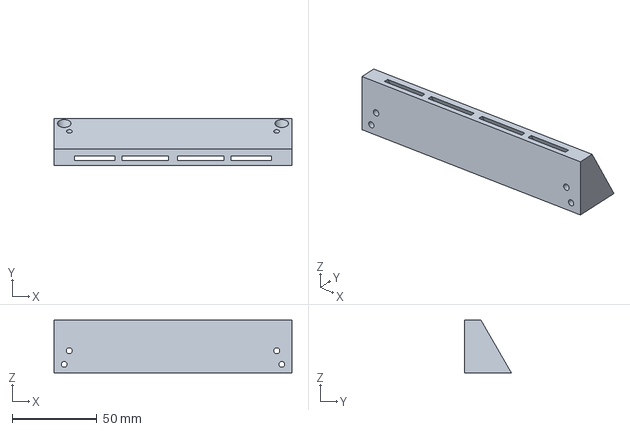
[picture p59: CAD file, 2026-10-27]
cad/variants/touch-8048/exports/rim_rail.step
140.0 x 27.5 x 31.0 mm
