bloodf/spoolancer/cad/variants/headless/exports/fit_esp32.step

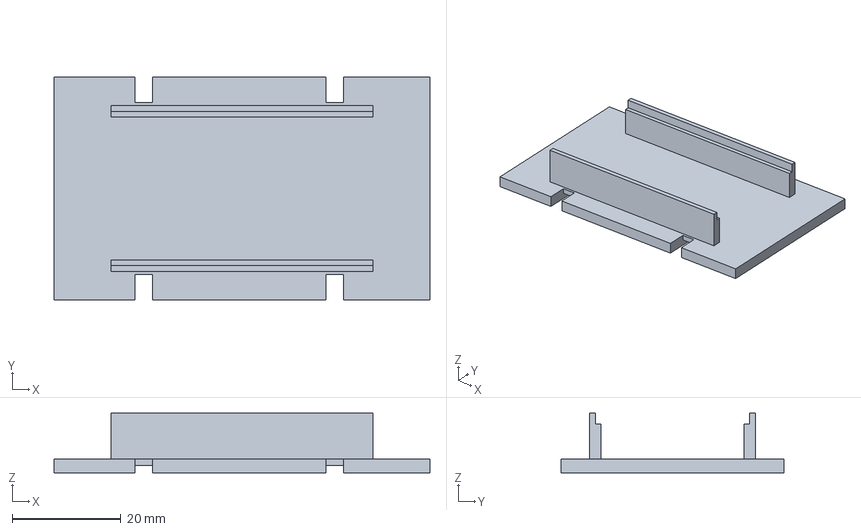
[picture p60: CAD file, 2026-10-27]
cad/variants/headless/exports/fit_esp32.step
69.0 x 41.0 x 11.0 mm
