bloodf/spoolancer/cad/variants/touch-8048/exports/touch_bridge.step

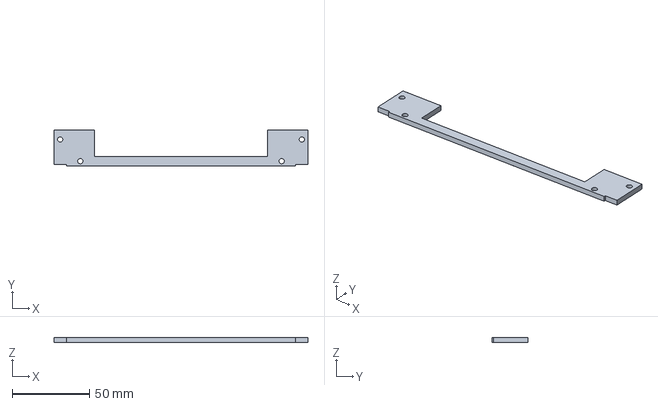
[picture p61: CAD file, 2026-10-27]
cad/variants/touch-8048/exports/touch_bridge.step
164.0 x 23.0 x 3.00 mm
