bloodf/spoolancer/cad/variants/touch-8048/exports/touch_bezel.step

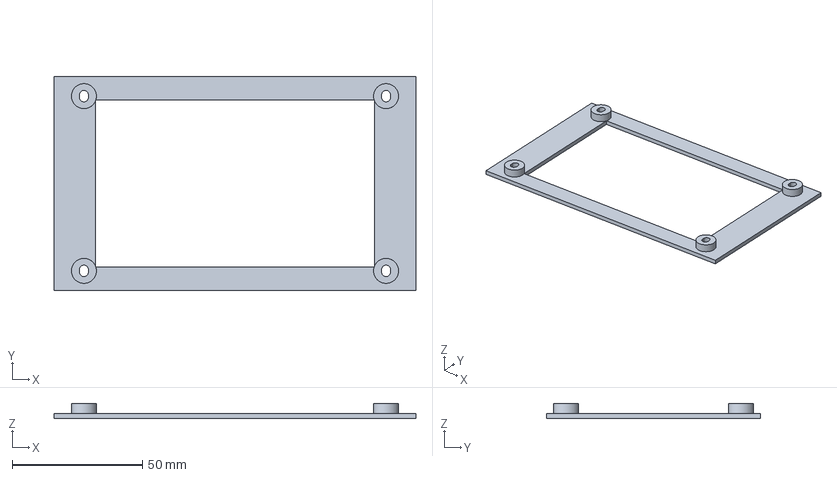
[picture p62: CAD file, 2026-10-27]
cad/variants/touch-8048/exports/touch_bezel.step
139.0 x 82.0 x 5.80 mm
