bloodf/spoolancer/cad/variants/touch-8048/exports/fit_touch_mount.step

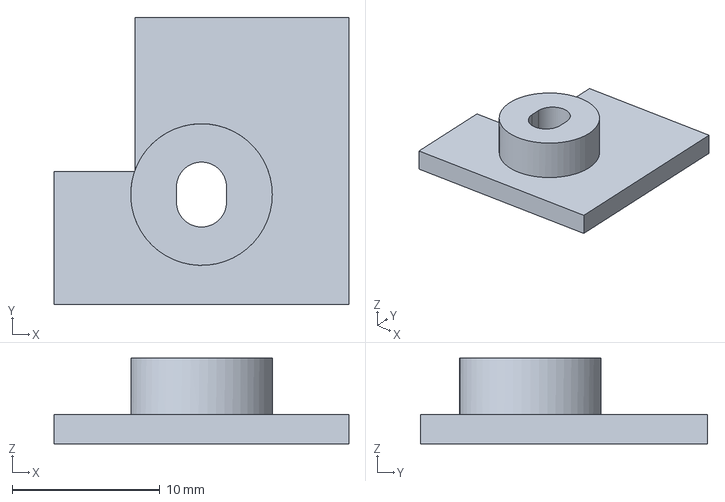
[picture p63: CAD file, 2026-10-27]
cad/variants/touch-8048/exports/fit_touch_mount.step
20.0 x 19.4 x 5.80 mm
