bloodf/spoolancer/(list of files, cad)

Other CAD files:
cad/variants/oled-led/exports/spoolancer-v0.8.1-oled-led-assembly.step
cad/variants/headless-led/exports/base.step
cad/variants/touch-8048/exports/nfc_pod.step
cad/variants/headless-led/exports/spoolancer-v0.8.1-headless-led.FCStd
cad/variants/headless-led/exports/nfc_cable_gate.step
cad/variants/touch-8048/exports/carrier.step
cad/variants/headless-led/exports/nfc_tower.step
cad/variants/headless/exports/nfc_pod.step
cad/variants/headless-led/exports/cradle.step
cad/variants/oled-led/exports/base_top_cover.step
cad/variants/touch-8048/exports/base.step
cad/exports/spoolancer-v0.4.1-headless.FCStd
cad/variants/headless-led/exports/nfc_cover.step
cad/variants/headless/exports/fit_cell.step
cad/variants/oled-led/exports/spoolancer-v0.8.1-oled-led.FCStd
cad/variants/headless-led/exports/cell_spacer.step
cad/variants/headless/exports/spoolancer-v0.4.1-headless.FCStd
cad/variants/oled-led/exports/nfc_cassette.step
cad/exports/fit_cell.step
cad/exports/nfc_pod.step
cad/variants/headless/exports/rim_rail.step
cad/variants/touch-8048/exports/nfc_guide.step
cad/exports/rim_rail.step
cad/variants/touch-8048/exports/side_guide.step
cad/variants/touch-8048/exports/fit_nfc.step
cad/variants/touch-8048/exports/spoolancer-v0.4-touch-8048.FCStd
archive/v0.1-flat/cad/exports/base.stl
archive/v0.1-flat/cad/exports/button_cap.stl
archive/v0.1-flat/cad/exports/fit_buttons.stl
archive/v0.1-flat/cad/exports/fit_display.stl
archive/v0.1-flat/cad/exports/fit_esp32.stl
archive/v0.1-flat/cad/exports/fit_nfc.stl
archive/v0.1-flat/cad/exports/front_panel.stl
archive/v0.1-flat/cad/exports/spoolancer-v0.1-assembly.step
archive/v0.1-flat/cad/exports/spoolancer-v0.1.FCStd
archive/v0.1-flat/cad/exports/tray.stl
archive/v0.2-upright/cad/exports/base.stl
archive/v0.2-upright/cad/exports/button_cap.stl
archive/v0.2-upright/cad/exports/carrier.stl
archive/v0.2-upright/cad/exports/fit_buttons.stl
archive/v0.2-upright/cad/exports/fit_display.stl
archive/v0.2-upright/cad/exports/fit_esp32.stl
archive/v0.2-upright/cad/exports/fit_nfc.stl
archive/v0.2-upright/cad/exports/saddle.stl
archive/v0.2-upright/cad/exports/side_guide.stl
archive/v0.2-upright/cad/exports/spoolancer-v0.2-assembly.step
archive/v0.2-upright/cad/exports/spoolancer-v0.2.FCStd
archive/v0.2-upright/cad/exports/top_cover.stl
archive/v0.3-compact/cad/exports/base.stl
archive/v0.3-compact/cad/exports/button_cap.stl
archive/v0.3-compact/cad/exports/fit_buttons.stl
archive/v0.3-compact/cad/exports/fit_display.stl
archive/v0.3-compact/cad/exports/fit_esp32.stl
archive/v0.3-compact/cad/exports/spoolancer-v0.3-assembly.step
archive/v0.3-compact/cad/exports/spoolancer-v0.3.FCStd
archive/v0.3-compact/cad/exports/top_cover.stl
cad/exports/base.stl
cad/exports/fit_esp32.stl
cad/exports/top_cover.stl
cad/variants/headless-led/exports/base.stl
cad/variants/headless-led/exports/base_top_cover.stl
cad/variants/headless-led/exports/cell_spacer.stl
cad/variants/headless-led/exports/cradle.stl
cad/variants/headless-led/exports/nfc_cable_gate.stl
cad/variants/headless-led/exports/nfc_cassette.stl
cad/variants/headless-led/exports/nfc_cover.stl
cad/variants/headless-led/exports/nfc_tower.stl
cad/variants/headless-led/exports/spoolancer-v0.8-headless-led-assembly.step
cad/variants/headless-led/exports/spoolancer-v0.8-headless-led.FCStd
cad/variants/headless/exports/base.stl
cad/variants/headless/exports/fit_esp32.stl
cad/variants/headless/exports/top_cover.stl
cad/variants/oled-led/exports/base.stl
cad/variants/oled-led/exports/base_top_cover.stl
cad/variants/oled-led/exports/cell_spacer.stl
cad/variants/oled-led/exports/cradle.stl
cad/variants/oled-led/exports/nfc_cable_gate.stl
cad/variants/oled-led/exports/nfc_cassette.stl
cad/variants/oled-led/exports/nfc_cover.stl
cad/variants/oled-led/exports/nfc_tower.stl
cad/variants/oled-led/exports/spoolancer-v0.8-oled-led-assembly.step
cad/variants/oled-led/exports/spoolancer-v0.8-oled-led.FCStd
cad/variants/touch-8048/exports/base.stl
cad/variants/touch-8048/exports/fit_touch_mount.stl
cad/variants/touch-8048/exports/top_cover.stl
cad/variants/touch-8048/exports/touch_bezel.stl
cad/variants/touch-8048/exports/touch_bridge.stl
cad/variants/touch-8048/exports/touch_stand.stl
