bloodf/spoolancer/docs/BUILD-GUIDE.md

# Build your first Spoolancer

Start with the **five-LED build** if you have an ESP32-S3 N16R8 and PN532. It uses your phone for controls and initial setup. The existing BOOT button provides Wi-Fi recovery. The optional ESP-8048S043C-I touchscreen replaces the separate ESP32.

This is a prototype release. CAD checks, firmware builds and software tests have passed; physical fit, calibrated accuracy, seated NFC operation and a real Spoolman connection still need testing. Record your results in the [hardware validation report](HARDWARE-VALIDATION.md).

The [v0.8.0-alpha.1 release](https://github.com/bloodf/spoolancer/releases/tag/v0.8.0-alpha.1) provides the complete source package, separate print packs for each build and `SHA256SUMS.txt`. The print packs contain individual STEP/STL files; the source package also contains the firmware, web interface and editable CAD generator.

## 1. Choose one controller

| Build | Controller | CAD folder | Firmware environment |
| --- | --- | --- | --- |
| Legacy headless, v0.4.1 | ESP32-S3 N16R8 development board matching the documented V6.0.0 board | [headless](../cad/variants/headless/) | `spoolancer-headless` |
| Five LEDs | Same standalone N16R8 board, five 5 V addressable pixels | [headless-led](../cad/variants/headless-led/) | `spoolancer-headless-led` |
| OLED + five LEDs | Same N16R8, 0.96-inch I²C OLED and five pixels | [oled-led](../cad/variants/oled-led/) | `spoolancer-oled-led` |
| Legacy integrated touch | ESP-8048S043C-I, 4.3-inch 800 × 480 capacitive | [touch-8048](../cad/variants/touch-8048/) | `spoolancer-touch-8048` |

The current LED/OLED v0.8.1 cases use eight broad printed pieces, a fixed-width cradle and [12 screws](BOM.md#current-ledoled-fasteners). Glue the broad reader-support joint, stationary base top cover and small cable cap as described in the [bonding guide](GLUE-ASSEMBLY.md). Existing v0.8 builders need the [new cover and cable cap](TOP-COVER.md). There are no external USB cutouts. Drill the DC jack opening after checking fit, and mount an insulated converter on a fixed wall. Convert 12 V to regulated 5 V and disconnect the converter before USB programming; follow [the power guide](DC-POWER.md). The original headless and integrated-touch mechanics are legacy versions with different joints.

Use only one controller. All builds share the 5 kg bar load cell, HX711 and PN532. Neither needs a separate setup button or perfboard. The touchscreen pin map differs from the headless map, and its microSD slot must remain empty.

Gather the [bill of materials](BOM.md), calipers, a multimeter, soldering tools and known calibration masses. The intended spool envelope is 50–100 mm wide and 160–220 mm in diameter. The firmware's weighing target is 20–2,000 g gross spool weight; the 5 kg cell also supports the moving mechanism.

## 2. Check the parts before a full print

1. Measure your board, connectors, load-cell holes and thread depths against the [mechanical references](MECHANICAL-SOURCES.md).
2. For v0.8, compare those measurements with the complete base, spacer and reader cassette. There are no separate fit coupons. Keep the eight individual files in their exported poses and inspect the [print guide](PRINTING.md). Legacy fit samples apply only to their own revisions.
3. Verify that the top BOOT access hole aligns with your actual board before fixing the board down. Remove the spool and use a blunt nonconductive probe; the button location is provisional. The old USB-opening BOOT access applies only to the legacy case.
4. Edit the current [simple geometry and dimensions](../cad/README.md#edit-and-regenerate-the-current-models) if measurements differ, then regenerate the whole matching set.

## 3. Wire and install the firmware

Follow the [complete wiring guide](../WIRING.md), including its [connection drawing](wiring/spoolancer-wiring-overview.svg) and [LED buffer detail](wiring/spoolancer-led-buffer.svg). The standalone LED/OLED build is the main guide; the integrated touch map is a separate appendix. Set both PN532 switches OFF for UART/HSU before powering it. PN532 and HX711 use 3.3 V supply and logic with common ground.

For normal operation, the LED/OLED case uses 12 V through the converter to the board's 5 V header. For flashing, follow the [J1/J2 power-isolation sequence](../WIRING.md#10-usb-programming-and-service), then use a USB data cable in **COM**. The legacy USB-powered headless board also uses COM; the touch board uses its own USB input. Peripheral power comes from verified 3V3/GND connections on the selected controller. Check the rail with Wi-Fi and NFC active before closing the enclosure.

Use the [firmware installation guide](../firmware/README.md#build-and-install) to build and upload **both** the application and web filesystem for your chosen environment. Verify detected 16 MB flash and 8 MB PSRAM. The source build is not a substitute for testing the real board, sensor and reader.

For a software preview before hardware assembly, serve `web/` as described in the [project README](../README.md#local-interface). Demo readings and simulated NFC/Spoolman actions do not use hardware or a real server.

## 4. Assemble and set up Wi-Fi

Use the [print manifest](PRINTING.md), then follow the [assembly guide](ASSEMBLY.md) in order. The load cell must be the only intended connection carrying weight from the moving cradle to the fixed base. Keep the NFC cable loop loose and clear of other parts. Tune the stops from measured movement; the initial modeled gap does not establish overload protection.

After normal power-up:

1. Join the temporary `Spoolancer-xxxx` network and open `http://192.168.4.1`.
2. Select a nearby 2.4 GHz Wi-Fi network and enter its password. Choose an eight-digit PIN or disable PIN protection for local access. Finish setup in the browser without pressing BOOT or opening the enclosure.
3. Wait for connection confirmation. Note the LAN address, reconnect your phone to that Wi-Fi and open the scale there. `http://spoolancer.local` may work where mDNS is supported.
4. Pair using your PIN if protection is enabled; without a PIN, local access opens automatically. Choose Light, Dark or System appearance in the browser.

The temporary setup network has no password, and setup uses HTTP. Use it in a trusted location. It closes after ten minutes or 60 seconds after the scale joins the LAN. For recovery, hold BOOT for eight seconds **while the firmware is running**, then release it. This clears Wi-Fi and pairing while retaining inventory, calibration and Spoolman settings. BOOT held during power-on or RST selects programming mode instead; release BOOT and press RST to start normally.

## 5. Calibrate and measure a spool

1. Open **Calibration** in the webpage and pair with the device. With the complete cradle, NFC pod and wiring installed, empty the cradle, let it settle and click **Zero empty scale**.
2. Place a known 100–2,000 g mass, enter its actual weight and choose **Save calibration**. Check other known masses and repeated placements using the [validation procedure](HARDWARE-VALIDATION.md#weighing).
3. Create a spool with its name, brand, material, color and known empty-spool weight. Unknown empty-spool weight cannot produce a trustworthy remaining-filament figure.
4. Select that record, place the spool upright, align its tag with the side reader and release the spool. Wait for a stable reading before saving.
5. Optionally link a tag or configure Spoolman. Start with a disposable Spoolman record and verify the resulting weight before using your inventory.

Writable NTAG216 tags use Spoolancer's own inventory format. Original Bambu Lab and Snapmaker tags are UID-only and read-only in this firmware. They can identify a manually entered local record; Spoolancer does not create printer-authenticated tags or decode proprietary material fields.

Spoolman is optional. The current integration accepts a numeric local IPv4 HTTP address, creates or links records, and explicitly updates absolute remaining weight. It has no automatic retry queue. If creation has an uncertain outcome, inspect Spoolman and reconcile the existing record before retrying. See the [web guide](WEB-INTERFACE.md) for normal use and the [firmware guide](../firmware/README.md#spoolman) for these limits.
