bloodf/spoolancer/cad/variants/touch-8048/previews/assembled.png

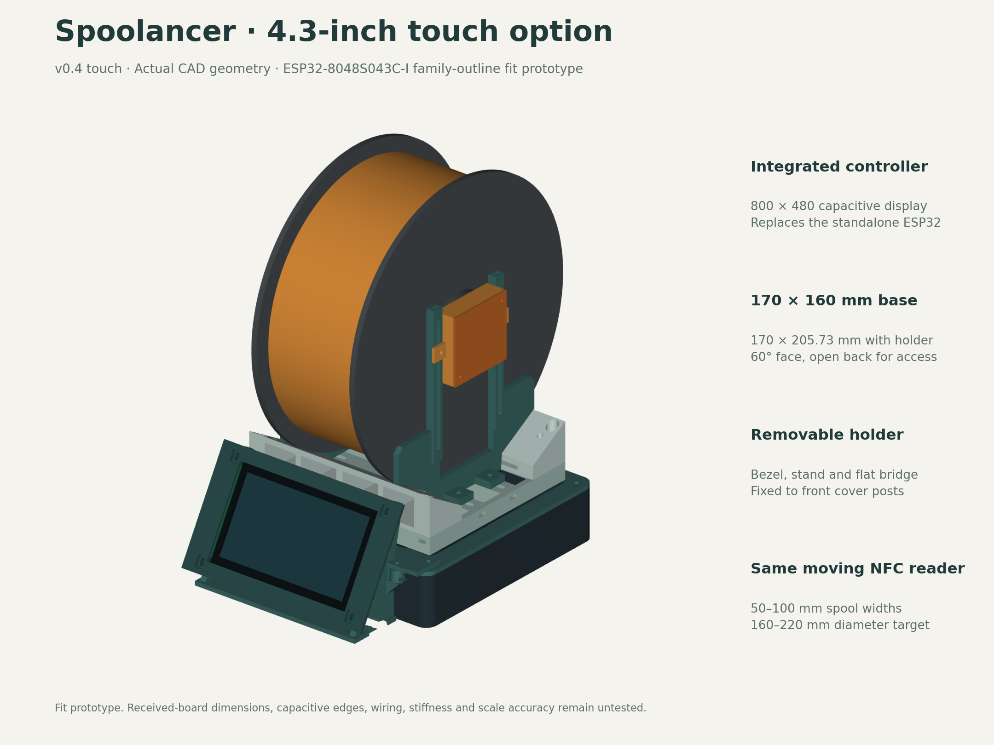
cad/variants/touch-8048/previews/assembled.png
