bloodf/spoolancer/docs/wiring/spoolancer-led-buffer.png

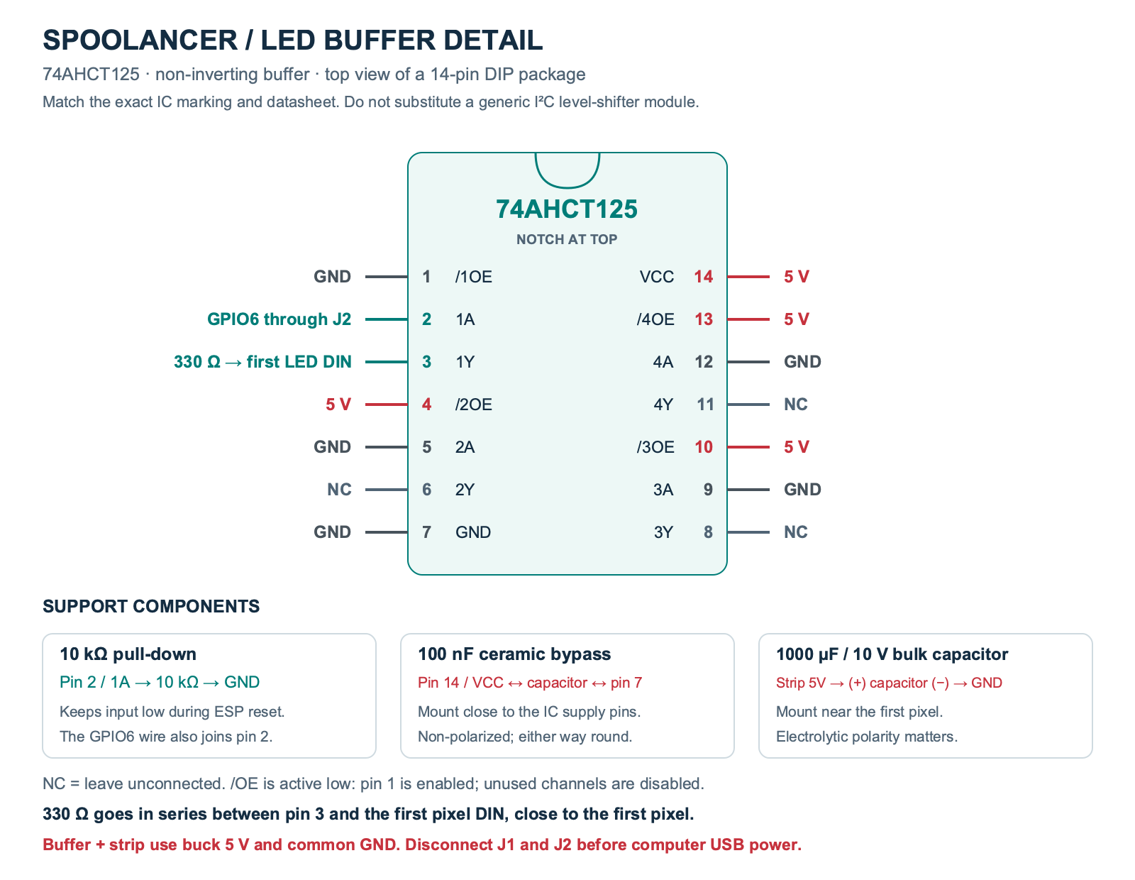
docs/wiring/spoolancer-led-buffer.png
