bloodf/spoolancer/docs/wiring/spoolancer-wiring-overview.png

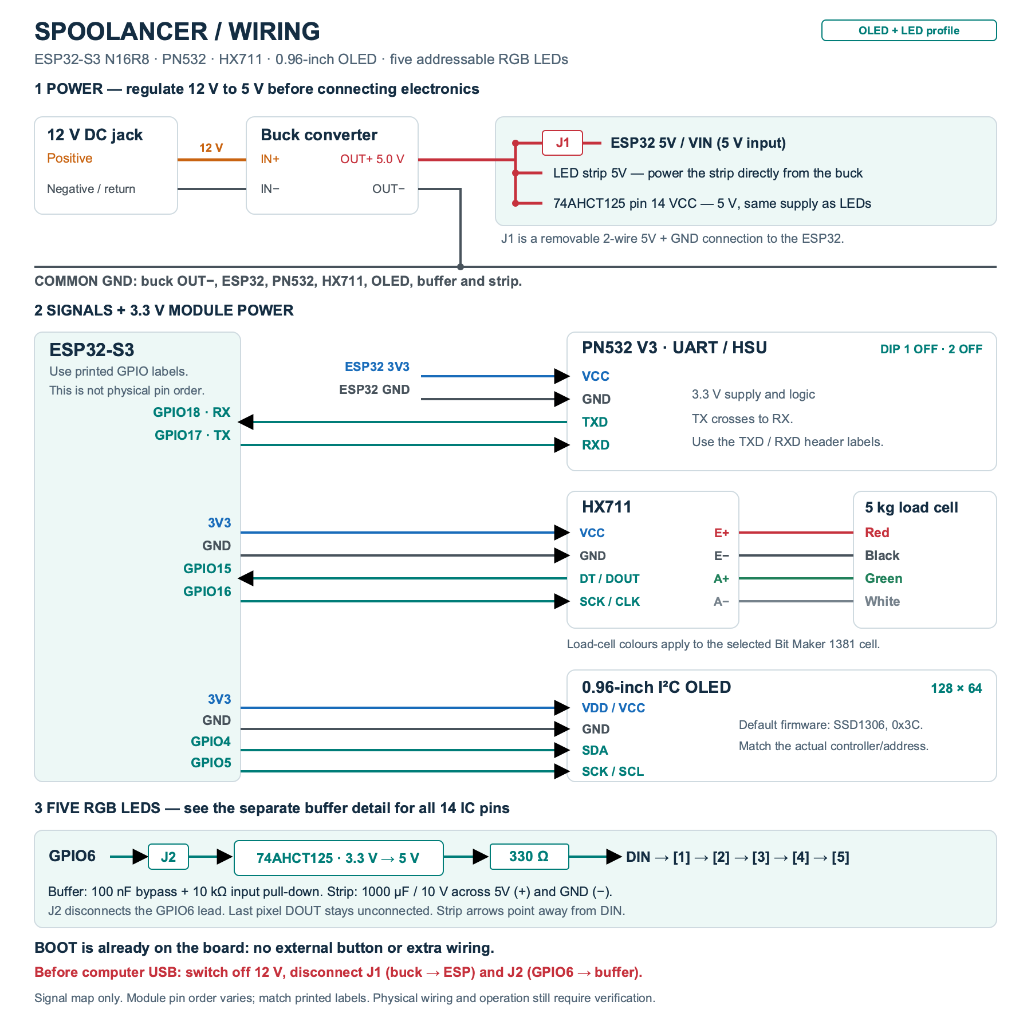
docs/wiring/spoolancer-wiring-overview.png
