bloodf/spoolancer/docs/web-hardware-tests.png

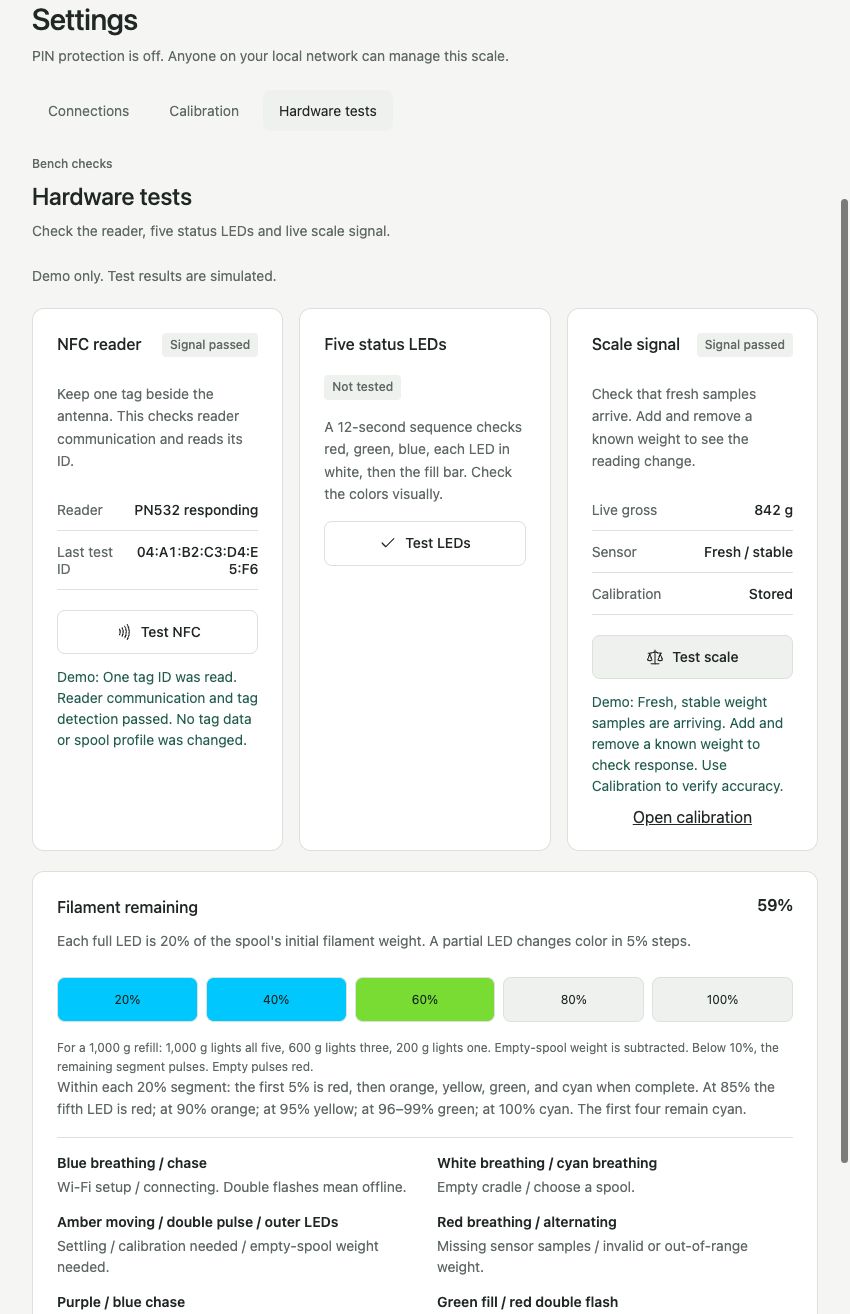
docs/web-hardware-tests.png
