bloodf/spoolancer/CHANGELOG.md

# Changelog

## 0.8.0-alpha.1

Rebuilds the LED-only and OLED/LED mechanical design around six broad printed parts. The old ten-piece frame, separate rails, sliding width guides and main lid are replaced by a rigid fixed-width cradle and open-top base. The NFC reader retains vertical adjustment and a hidden wire loop.

- Base and cradle print on full flat undersides; the reader support, cassette and rear cover print with broad faces down.
- Integral ramps, an 8 mm cradle floor, thick walls and broad mounting seats replace thin rails and tabs.
- Twelve screws in three sizes, with one broad glued reader-support joint. No glue on the load cell or its moving/fixed gap.
- Six STEP/STL pairs per variant, editable geometry, native FreeCAD, assembled/exploded/print-pose views and updated assembly viewer.
- Reopened export and collision checks plus actual support-enabled OrcaSlicer diagnostics on P1S and U1 profiles. Results and limits are in `analysis/printability-v0.8/`.

Physical printing, bond strength, seated NFC, calibration and stability remain untested. The original headless/touch designs and firmware are unchanged.

## Historical v0.7 documentation

- Add an 18-screw glued-rail assembly option for the existing v0.7 LED/OLED prints, saving two metal M3 × 12 screws, two nuts and two washers. Document bonding locations, preparation, permanent-rail service and the remaining mechanical fasteners.
- Keep all CAD files, the 20-screw reference assemblies and existing release ZIPs unchanged. Adhesive strength and physical assembly remain untested.

## 0.7.0-alpha.1

Simplifies assembly of the current LED-only and OLED-plus-LED cases. Screw count falls from 28 to 20, and dimensional sizes fall from nine to three. Metal and nylon M3 × 12 screws are separate purchasing lines. The original headless and integrated-touch designs are unchanged.

- Two rigid rear hooks and two front M3 × 12 screws retain the main lid.
- Two locating keys and one central M3 × 12 screw retain each rim rail. Each sliding guide keeps two screws.
- Raised stop posts use M3 × 12 screws with the same provisional 1 mm unloaded gap and adjustable locknuts.
- The PN532 rests on PCB-edge supports and soft shims. Its mounting holes need no screws. The reader pod cover and cable cover each use one nylon M3 × 12 screw and a rigid locating tongue.
- Reader-height clamps use the same nylon M3 × 12 size. The two M4 × 25 and two M5 × 12 load-cell screws remain matched to the modeled cell threads.
- Updated CAD, print files, assembly views, purchasing quantities and service instructions. Both variants retain ten printed production pieces.

Physical fit, joint retention, strength and weighing accuracy remain unvalidated. Firmware is unchanged at `0.5.0-prototype`; this update performs no device flash. See [verification limits](docs/STATUS.md).

## 0.6.0-alpha.1

Redesigns the two LED cases with integrated vertical front controls, a covered adjustable-reader cable route and chamfered exposed edges. Adds a full interactive assembly guide. Upright spool support and 100 mm width adjustment remain. Physical fit remains unvalidated.

- Vertical front-wall OLED and LED supports replace the tilted external pod and its separate rear cover. Components are serviced through the main lid.
- A cable channel integrated into the NFC guide stores height-adjustment slack behind one removable cover.
- Actual CAD chamfers give the exposed housing, cradle, guide and cover edges a consistent bevel; functional mounting and sliding surfaces retain their checked clearances.
- Regenerated individual STEP/STL pairs, native FreeCAD files and complete assembly STEP for the LED-only and OLED-plus-LED cases. The original headless and integrated-touch CAD are unchanged.
- Standalone 3D viewer with both variants, numbered selection, hide/isolate/focus controls, reference toggles, light/dark appearance and an exploded-view slider. Real CAD meshes and Three.js are bundled for offline use through a local static server.
- Numbered exploded images, component-location, cable-routing and edge-detail views in the source and print downloads. Part numbers are shared with the viewer.
- Geometry/export checks, deterministic mesh rebuild checks, viewer behavior tests and GitHub Pages publishing workflow.
- NFC tag guide distinguishing manufacturer-signed Bambu/Snapmaker tags from writable Spoolancer NTAG216 inventory.

Firmware is unchanged and still identifies itself as `0.5.0-prototype`. This release does not flash a device or establish peripheral, DC-power or physical enclosure operation. See [verification limits](docs/STATUS.md).

## 0.5.0-alpha.1

Adds five-LED and OLED-plus-five-LED variants using the existing standalone ESP32-S3. Both retain the upright cradle and seated side NFC reader. Physical fit and scale operation remain unvalidated.

- Two DC-input case prototypes with five round openings at 16.667 mm pitch, closed USB walls, separate BOOT access and removable front pods. The builder drills the jack hole and mounts a separate 12 V-to-5 V converter.
- Fifteen LED-only and sixteen OLED STEP/STL pairs, including fit samples, plus editable FreeCAD/assembly STEP. Prior released CAD remains unchanged.
- New firmware profiles show a valid remaining-weight bar, operation feedback and optional OLED status. Missing/stale measurements and ambiguous NFC reads do not produce success indicators.
- GPIO4/5 OLED I²C and GPIO6 LED data, configurable controller/address/color order and 20% default brightness. Hardware identities remain provisional.
- All five firmware profiles compile; native sanitizer tests, 26 web tests and both new asset images pass. New CAD exports reopen and pass modeled clearance checks.
- One ESP32-S3 was backed up, flashed and booted over USB. Serial output confirmed 16 MB flash, approximately 8 MB PSRAM, mounted assets/inventory and setup address. OLED was not detected at `0x3c`; other peripheral and DC-power behavior is untested.

The application identifies itself as `0.5.0-prototype`. See [verification limits](docs/STATUS.md) and [the boot record](docs/DEVICE-BOOT.md).

## 0.4.1-alpha.1

First public prototype release. This is a source and CAD release; physical assembly, weighing accuracy, NFC range and live Spoolman operation still need validation.

- Compact upright cradle for proposed spool widths of 50–100 mm, with the NFC reader on the moving side guide.
- Screenless ESP32-S3 N16R8 and optional ESP-8048S043C-I capacitive-touch variants.
- Individual STEP and STL files for every current printable part and fit sample, plus assembly STEP, native FreeCAD documents and editable generation scripts.
- Local browser interface for weighing, inventory, color/material/brand editing, calibration, Wi-Fi setup, light/dark appearance and optional Spoolman synchronization.
- Onboard BOOT handles setup and Wi-Fi recovery. No separate button or perfboard is required.
- NTAG216 inventory records with read-back verification. Original printer tags can be linked by UID; proprietary decoding and printer-recognized custom tags are not implemented.
- MIT license, project icon, build/printing guides, contribution templates, automated software checks and checksummed release bundles.

The application identifies itself as `0.4.1-prototype`. The release suffix describes the public package's pre-release status. Historical local revisions are preserved under `archive/`; they are not current build instructions.
