bloodf/spoolancer/(commit log)

2026-10-27 feat: release Spoolancer prototype with editable CAD and local inventory
    [base.step, base.stl, button_cap.stl, carrier.step, carrier.stl, fit_buttons.stl, fit_cell.step, fit_cell.stl]
2026-10-27 feat: add OLED and five-LED DC enclosure variants
    [base.step, base.stl, carrier.step, carrier.stl, fit_cell.step, fit_cell.stl, fit_esp32.step, fit_esp32.stl]
2026-10-27 feat: add rounded CAD and interactive assembly explorer
    [base.step, base.stl, carrier.step, carrier.stl, fit_cell.step, fit_esp32.step, fit_led_carrier.step, fit_led_face.step]
2026-10-27 feat: integrate vertical controls and concealed NFC wiring
    [base.step, base.stl, carrier.step, carrier.stl, fit_cell.step, fit_esp32.step, fit_esp32.stl, fit_led_carrier.step]
2026-10-27 feat(cad): reduce LED assemblies to twenty screws
    [base.step, base.stl, carrier.step, carrier.stl, fit_cell.step, fit_esp32.step, fit_esp32.stl, fit_led_carrier.step]
2026-10-27 docs: add eighteen-screw glued rail assembly option
2026-10-28 feat(cad): rebuild spool scale as six broad printable parts
    [base.step, base.stl, carrier.step, carrier.stl, cell_spacer.step, cell_spacer.stl, cradle.step, cradle.stl]
2026-10-29 docs: add complete wiring and power guide
2026-10-29 feat(web): add guided scale calibration
2026-10-30 fix(firmware): prevent OLED initialization from stalling startup
    [StatusUi.cpp, main.cpp]
2026-11-02 feat(nfc): write printer-brand tags and read/clone Bambu & Snapmaker
    Write filament tags that stock printer firmware accepts, reproducing the
    layouts of the open-source writers those printers already read:
    - Creality CFS: MIFARE Classic 1K sector 1, AES-128-ECB with UID-derived key
    - Qidi Box: Classic block 4 (material + nearest palette color)
    - Anycubic ACE: NTAG21x pages 4-31 (material, color, temps, length, weight)
    - Elegoo Canvas: NTAG21x pages 16-24
    - OpenSpool: NTAG215/216 NDEF application/json
    Read genuine Bambu Lab and Snapmaker U1 tags by deriving their MIFARE
    sector keys from the UID (Bambu HKDF-SHA256, Snapmaker HMAC-SHA256) to
    identify the spool. Both are RSA-signed and cannot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
    [BrandTags.h, Discovery.h, Domain.h, JsonNumbers.h, Nfc.cpp, Nfc.h, ReadTags.h]
2026-11-02 chore(cad): rebuild v0.8.1 hardware, refresh docs, viewer and CI
    Rebuild the headless-led and oled-led variants as v0.8.1 (new base/top-cover
    split, nfc_cable_gate, regenerated STEP/STL/FCStd exports and previews). Drop
    the stale analysis/ printability and material-comparison snapshots. Refresh
    the docs set (assembly, BOM, printing, NFC tags, top cover, UX review, web
    interface screenshots), the 3D viewer assets, the packaging/delivery tools,
    and add the ArduinoJson numeric-JSON CI step.
    [base.step, base_top_cover.step, base_top_cover.stl, cell_spacer.step, cradle.step, nfc_cable_gate.step, nfc_cable_gate.stl, nfc_cassette.step]
2026-11-02 feat(ota): GitHub-release firmware updates and a release pipeline
    Add over-the-air updates driven by this repository's GitHub releases. The
    device (Settings -> Hardware tests -> Firmware update) resolves the latest
    release, downloads the littlefs and firmware images named for its own board
    variant, flashes the filesystem then the app, and reboots. Exposes
    GET /api/update (check) and POST /api/update (confirm and apply); the running
    version now comes from the SPOOLANCER_VERSION build flag instead of a constant.
    Add .github/workflows/release.yml: a vX.Y.Z tag (or manual dispatch) builds
    every variant's firmware and filesystem image, injects the tag as the firmware
    version, and publishes them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
    [Ota.h, domain_test.cpp, main.cpp, ota_test.cpp, run.py]
2026-11-02 feat(ota): upload-and-flash a firmware .bin from the web panel
    Add POST /api/update/upload: a multipart firmware image is streamed straight
    into the inactive OTA slot via the Update API, verified, and the device reboots
    into it. The endpoint requires a paired session and an explicit confirm=true.
    The Firmware update card gains an advanced "Upload & flash" control that posts a
    chosen .bin after a confirmation prompt, alongside the existing GitHub-release
    update. Both update paths require the user to approve before anything is flashed.
    [main.cpp]
